ben5049/phy-module-hardware/README.md

# PHY Module Hardware

## 10BASE-T1S v1

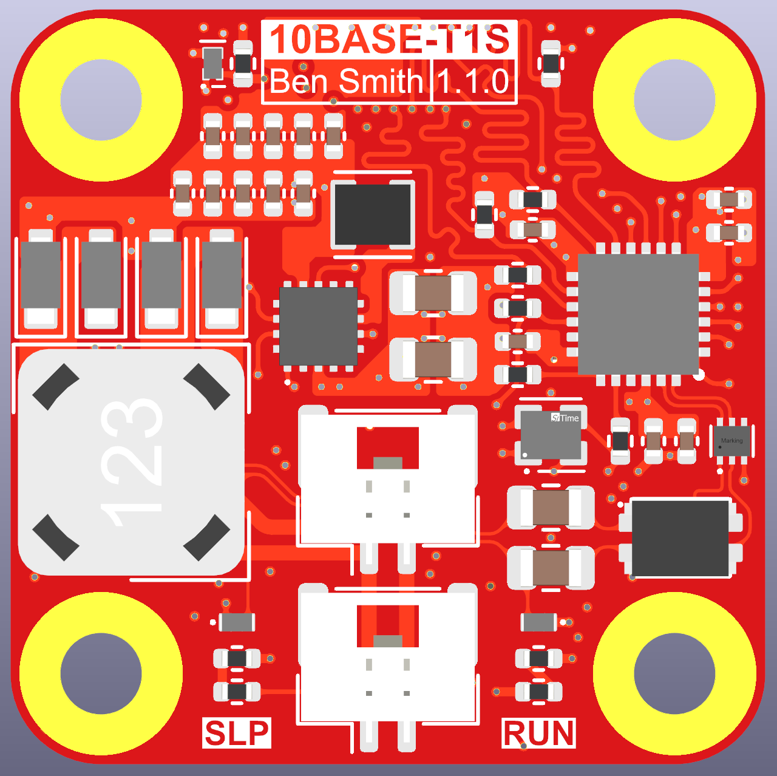
[picture p1: docs/images/10base-t1s.png]
10base-t1s


[Errata](/docs/errata.md#1-10base-t1s-phy-module-v1)

## 1000BASE-T1 v1

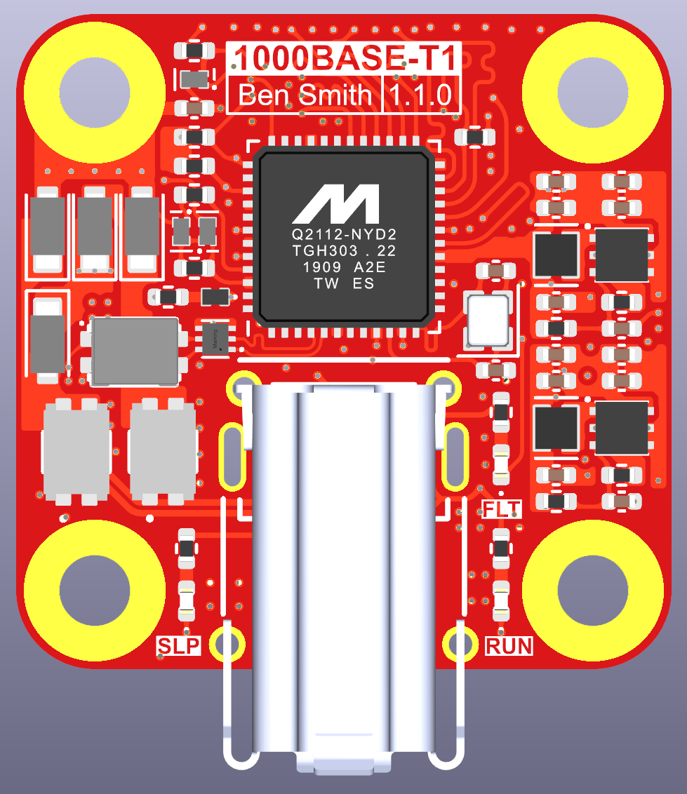
[picture p2: docs/images/1000base-t1.png]
1000base-t1


[Errata](/docs/errata.md#2-1000base-t1-phy-module-v1)
