ben5049/phy-module-hardware/docs/schematics/phy-module-10-base-t1s-v1.pdf

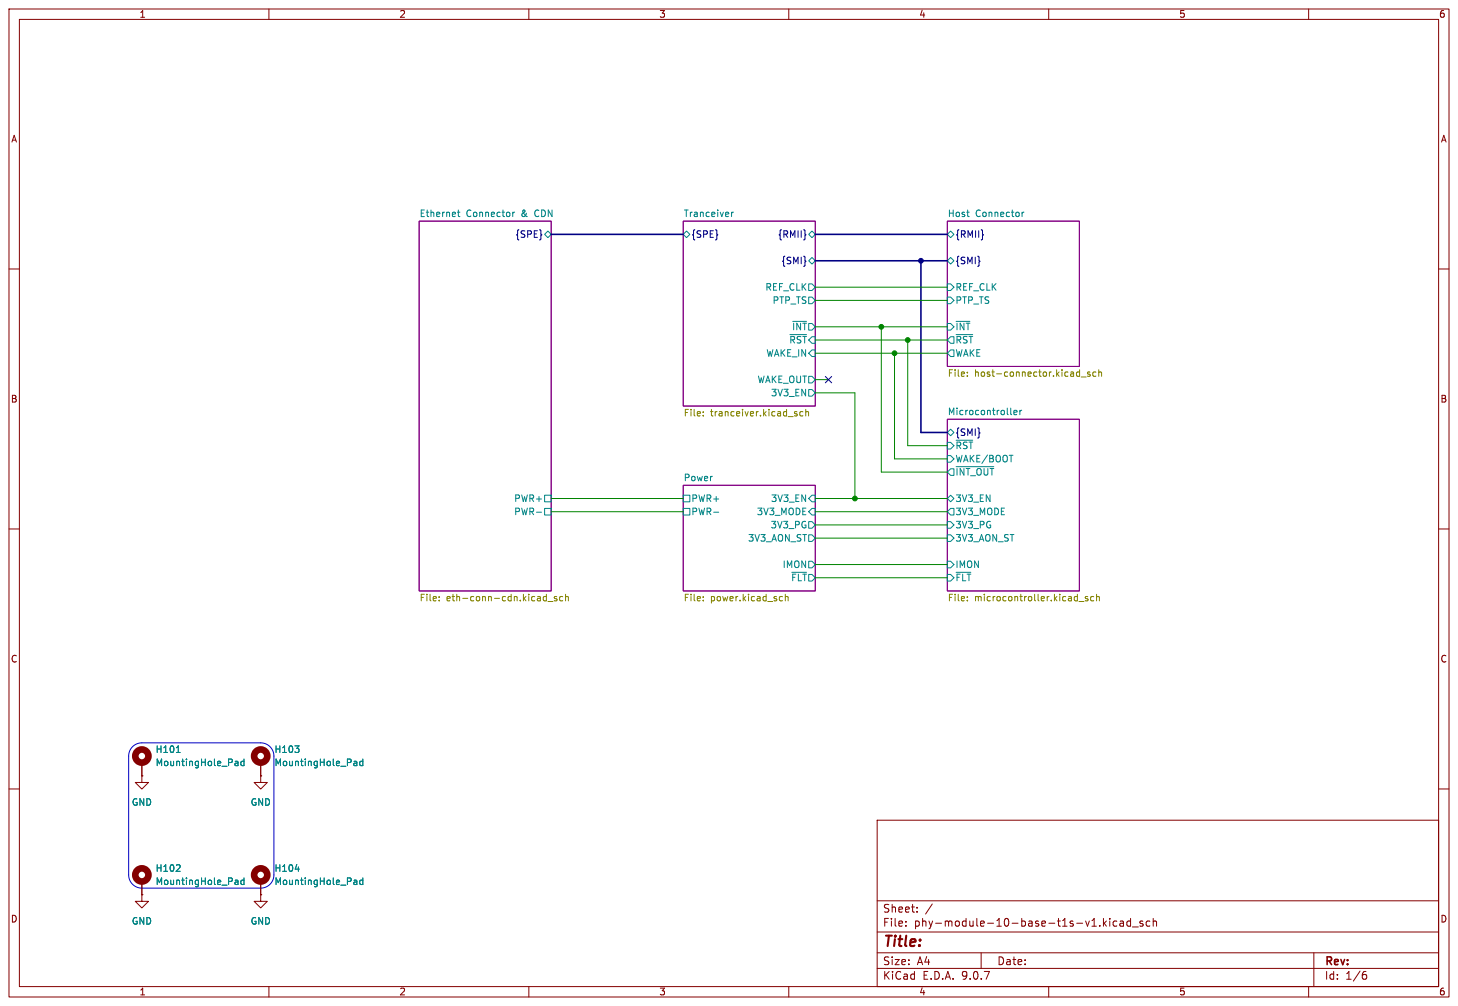
[picture p3: page 1]

~{RST} Host Connector File: host-connector.kicad_sch PWR+ PWR-

File: eth-conn-cdn.kicad_sch H101 MountingHole_Pad GND

Id: 1/6 Title: File: phy-module-10-base-t1s-v1.kicad_sch Sheet: /

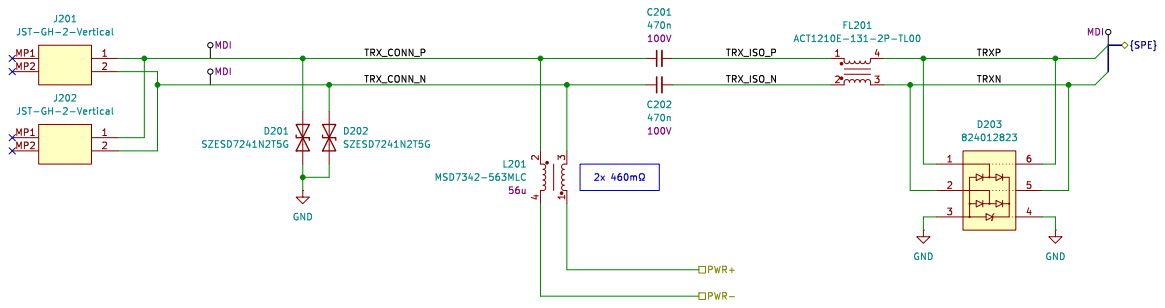
[picture p4: page 2]

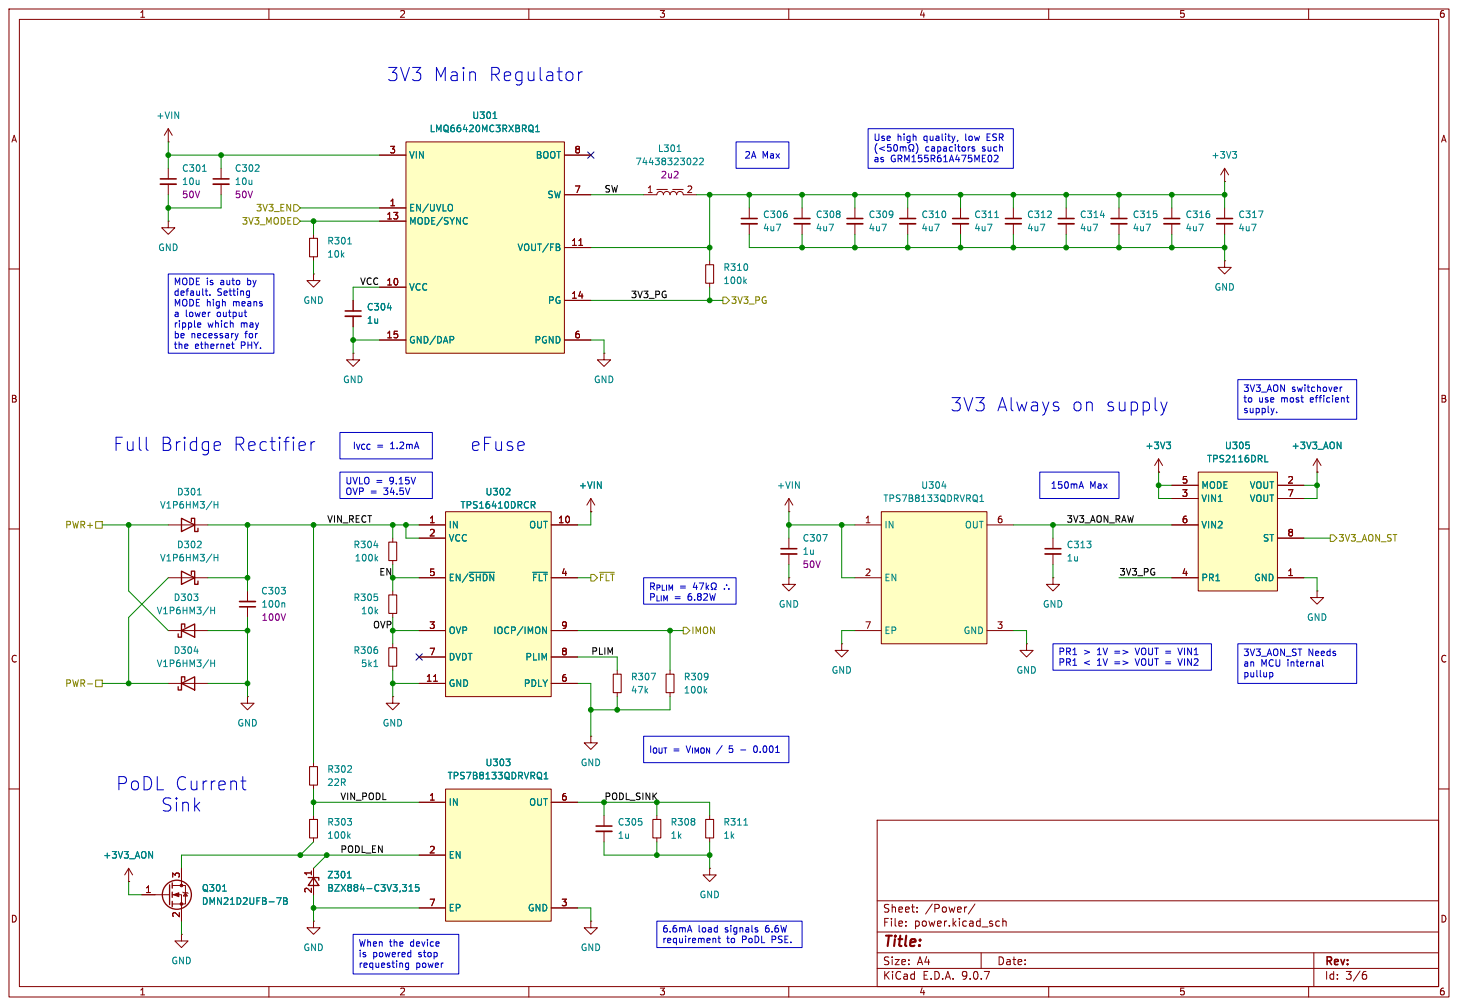
[picture p5: page 3]

as GRM155R61A475ME02 UVLO = 9.15V OVP = 34.5V When the device

to use most efficient supply.

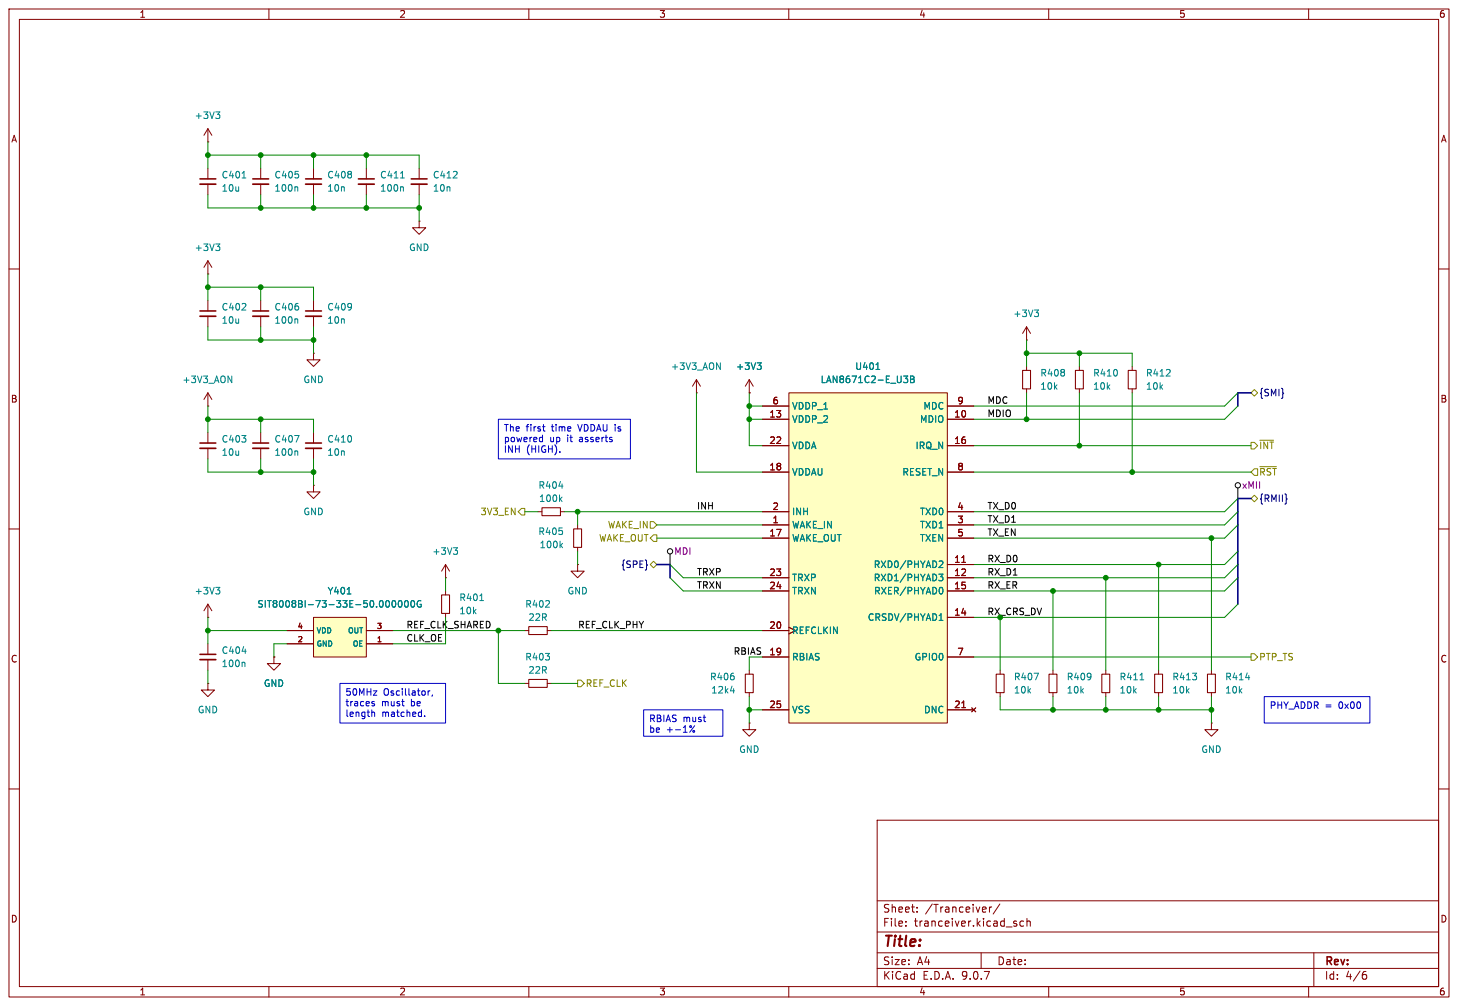
[picture p6: page 4]

The first time VDDAU is powered up it asserts

Id: 4/6 Title: File: tranceiver.kicad_sch Sheet: /Tranceiver/

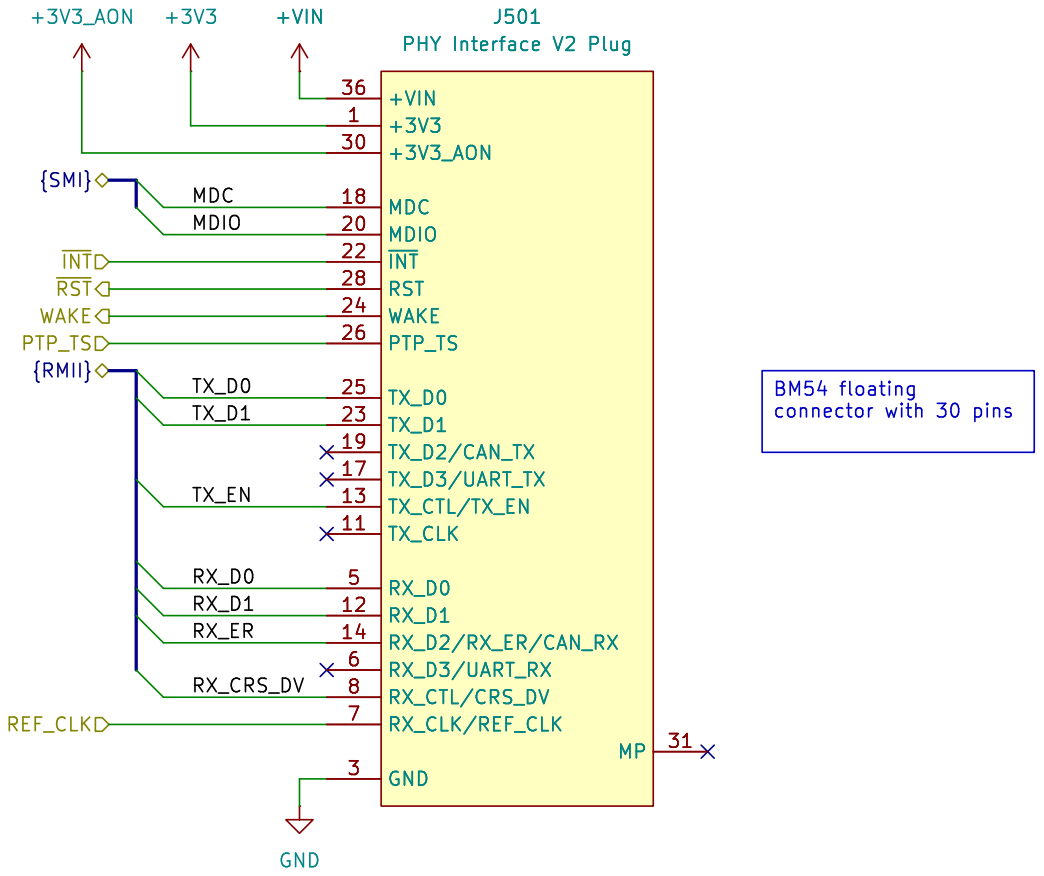
[picture p7: page 5]

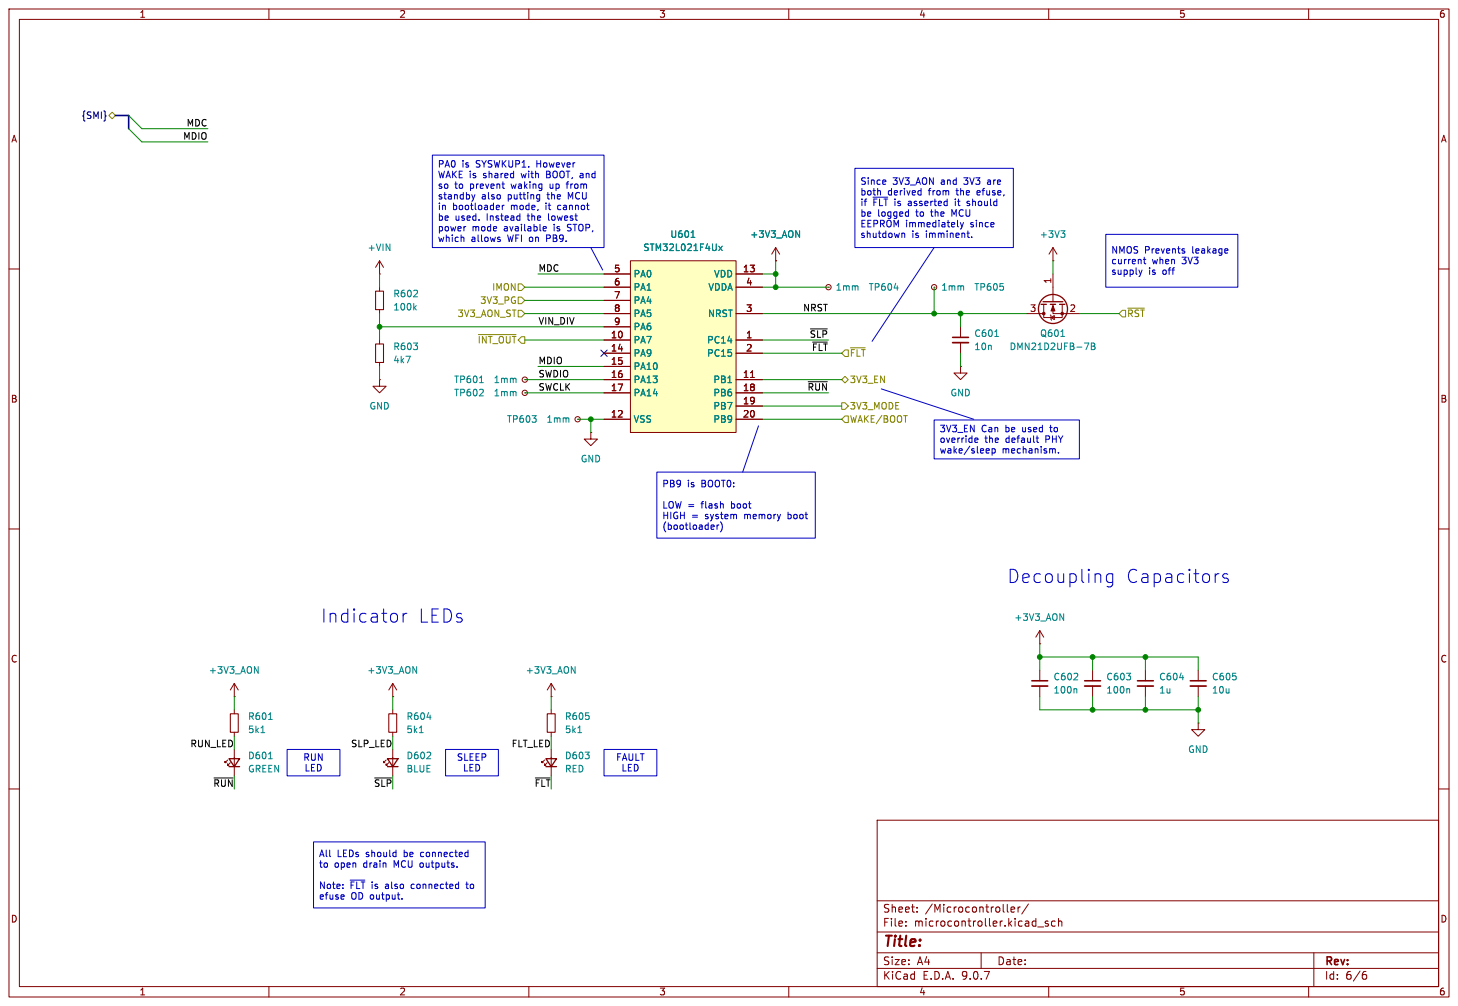
[picture p8: page 6]

PA0 is SYSWKUP1. However WAKE is shared with BOOT, and
so to prevent waking up from

both derived from the efuse,
if ~{FLT}is asserted it should
be logged to the MCU

shutdown is imminent. All LEDs should be connected

supply is off FAULT

3V3_EN Can be used to

Id: 6/6 Title: File: microcontroller.kicad_sch Sheet: /Microcontroller/
