ben5049/phy-module-hardware/docs/schematics/phy-module-1000-base-t1-v1.pdf

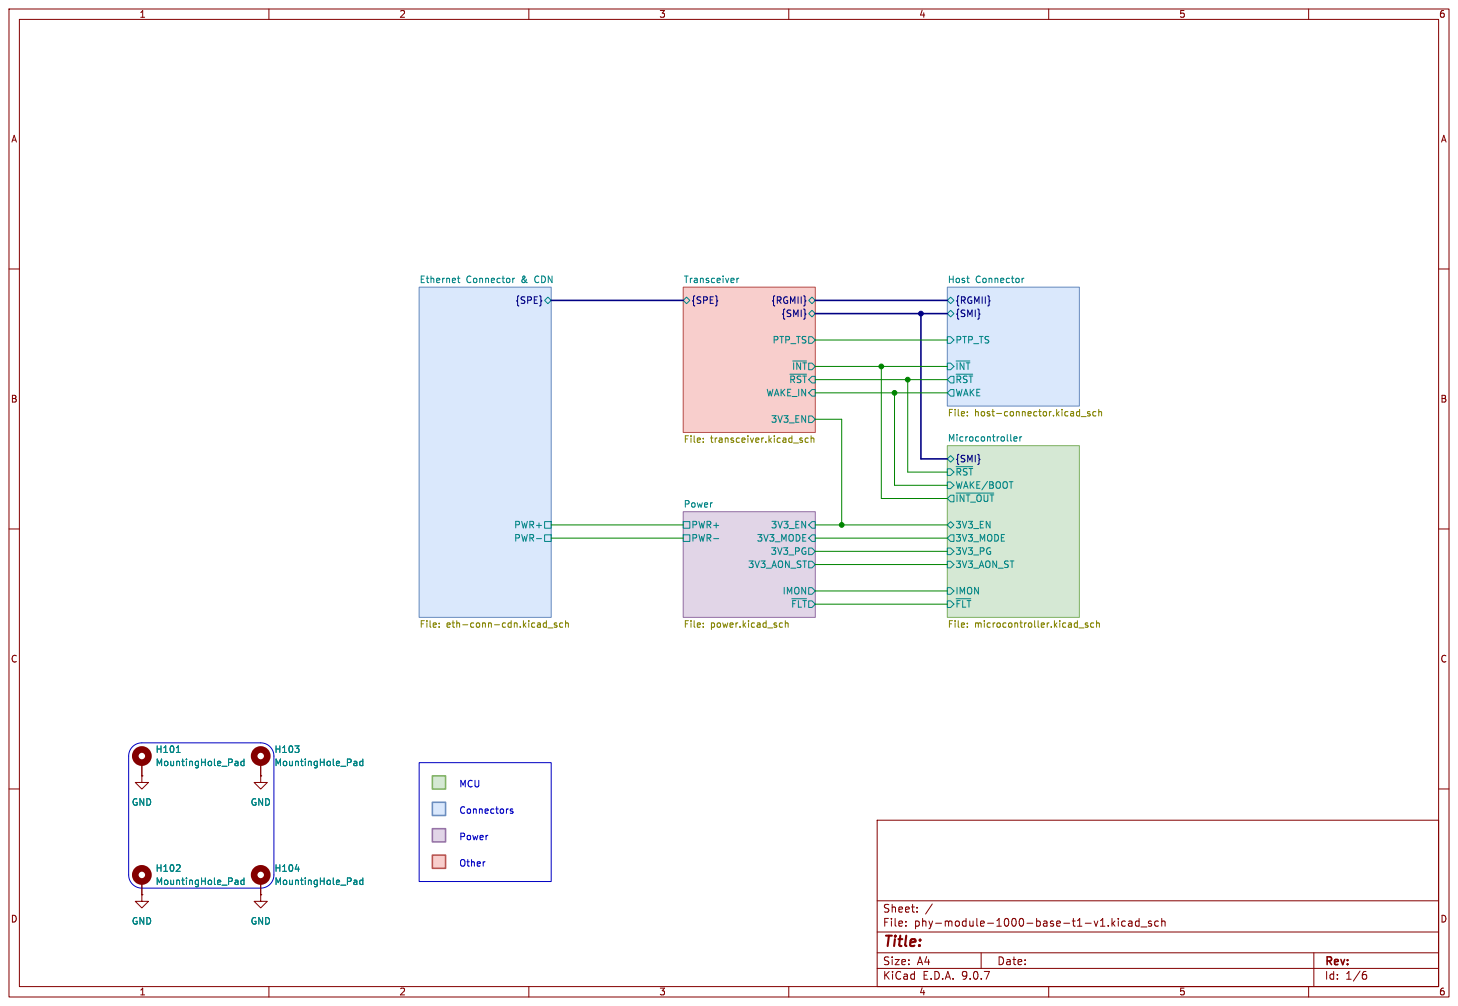
[picture p9: page 1]

{RGMII} Host Connector File: host-connector.kicad_sch
{SMI} PTP_TS WAKE

Id: 1/6 Title: File: phy-module-1000-base-t1-v1.kicad_sch Sheet: / WAKE_IN

{SMI} 3V3_MODE Microcontroller File: microcontroller.kicad_sch GND

Power File: power.kicad_sch PWR+ PWR-

File: eth-conn-cdn.kicad_sch

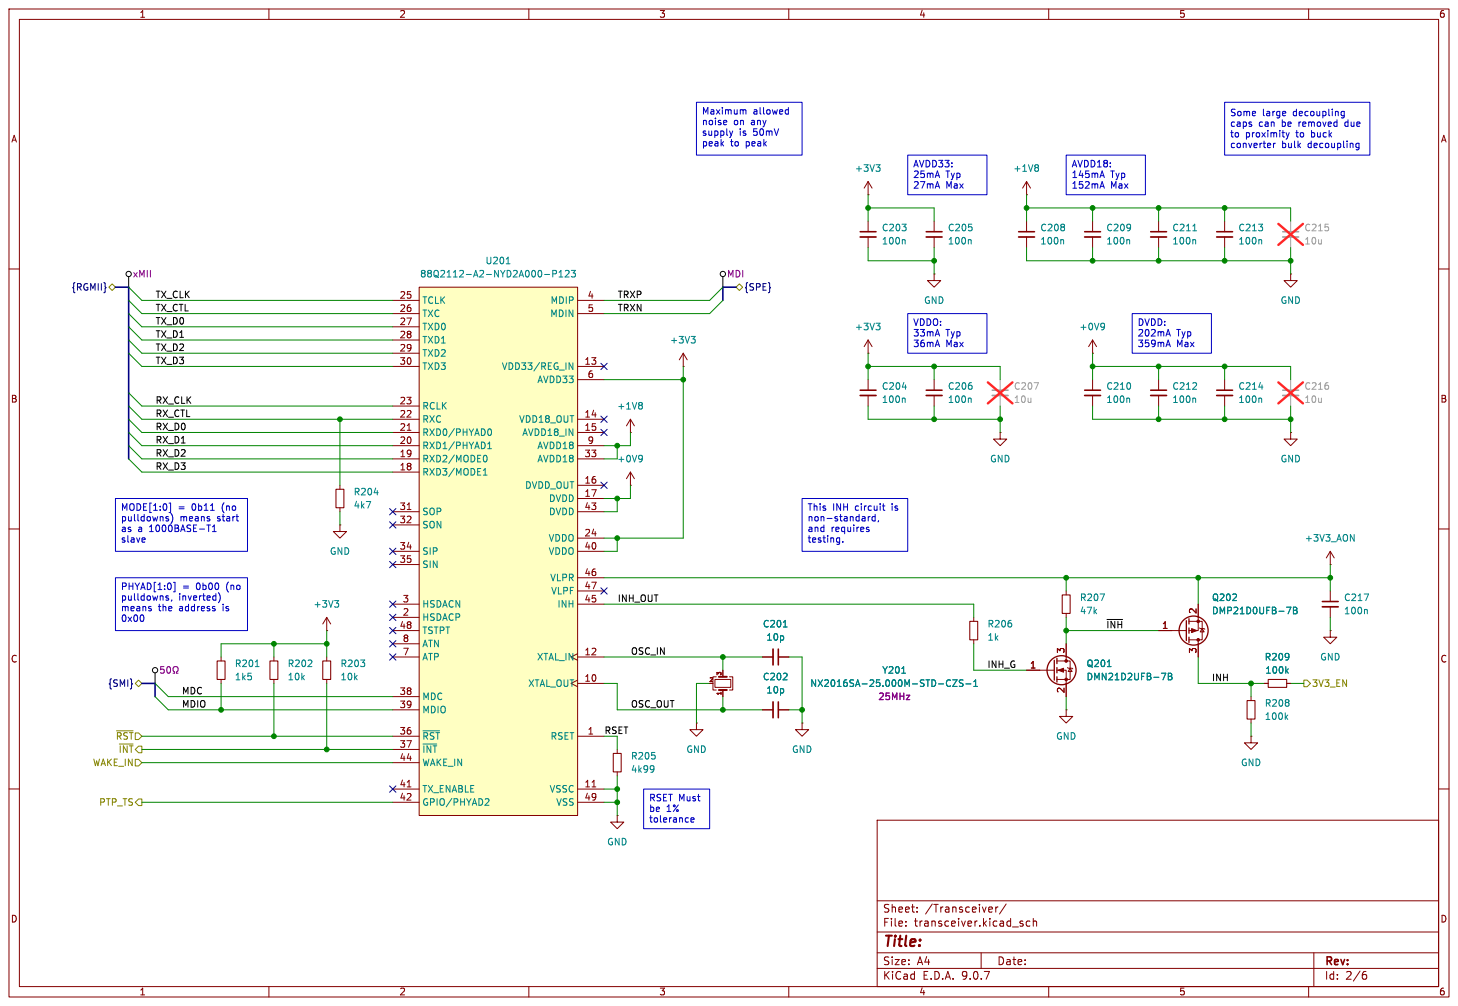
[picture p10: page 2]

caps can be removed due

359mA Max RSET Must be 1%

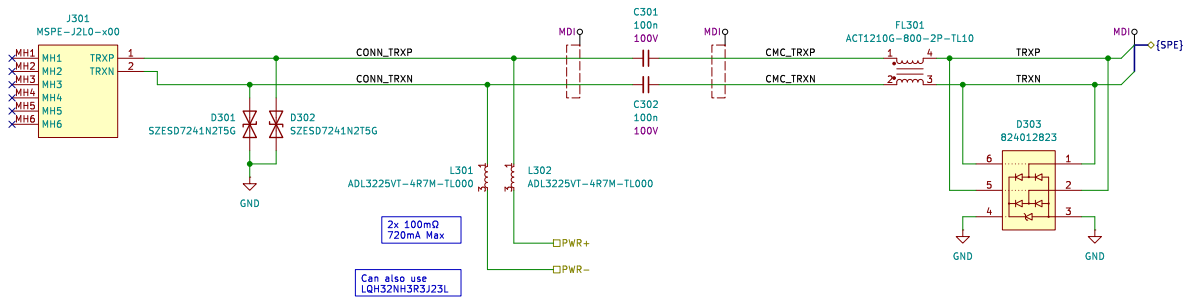
[picture p11: page 3]

720mA Max Can also use

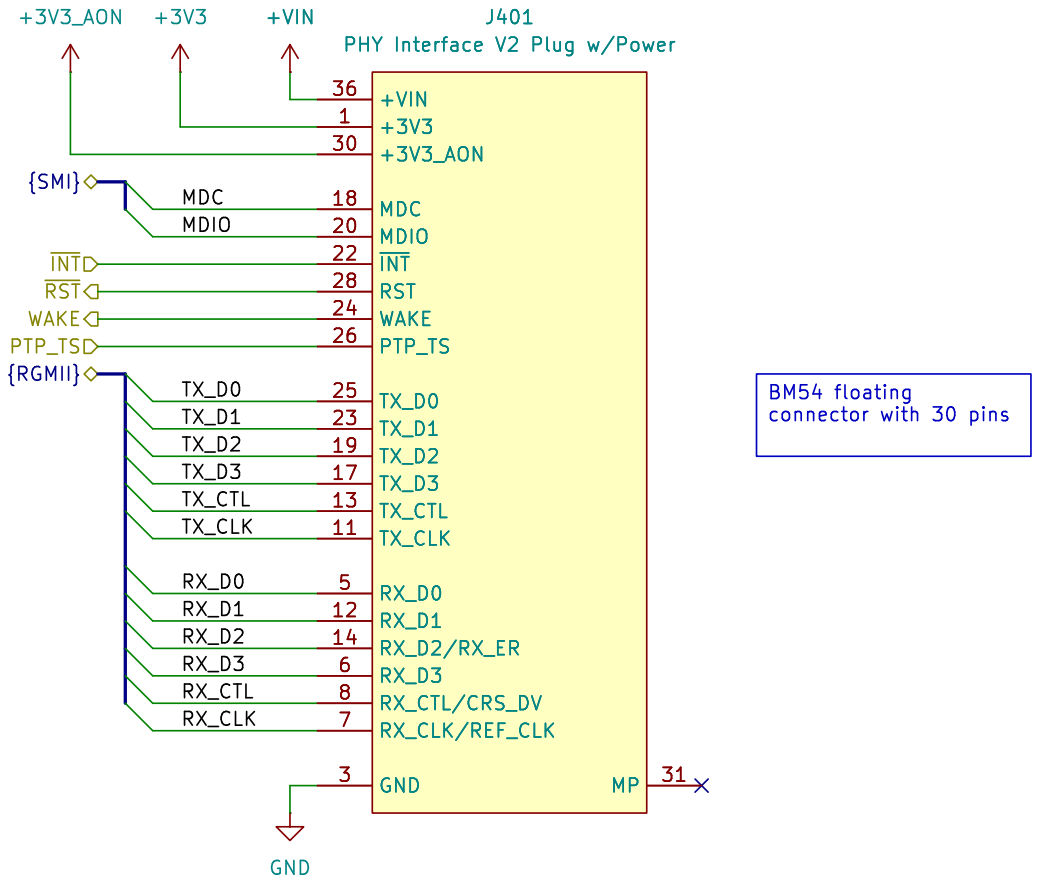
[picture p12: page 4]

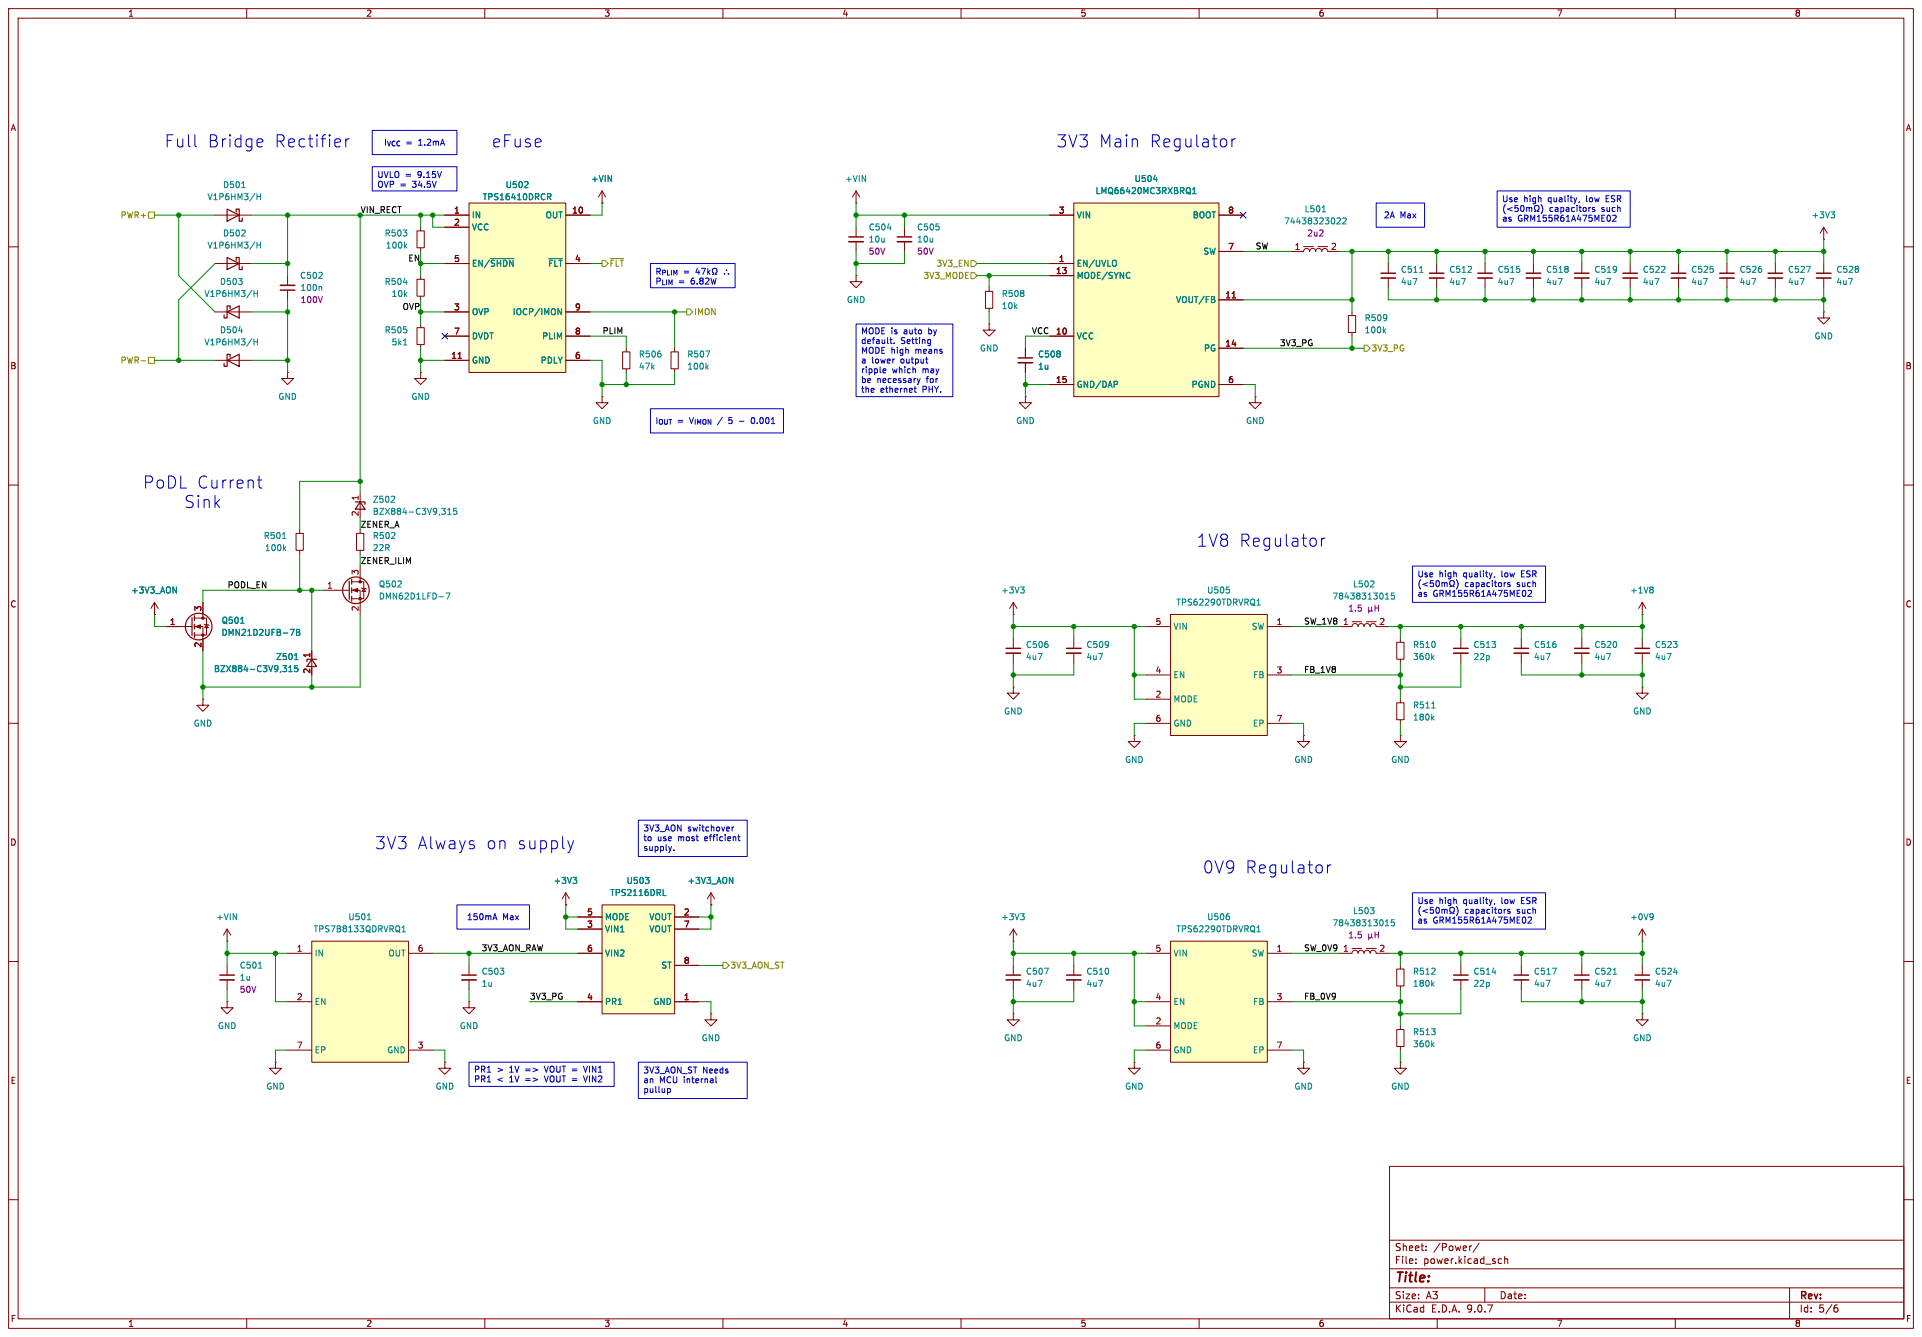
[picture p13: page 5]

as GRM155R61A475ME02 R_{PLIM} = þÿ47k©þÿ"4
P_{LIM}= 6.82W

I_{OUT} = V_{IMON} / 5 - 0.001 3V3 Always on supply

3V3_AON switchover
to use most efficient supply.

3V3_AON_ST Needs an MCU internal pullup

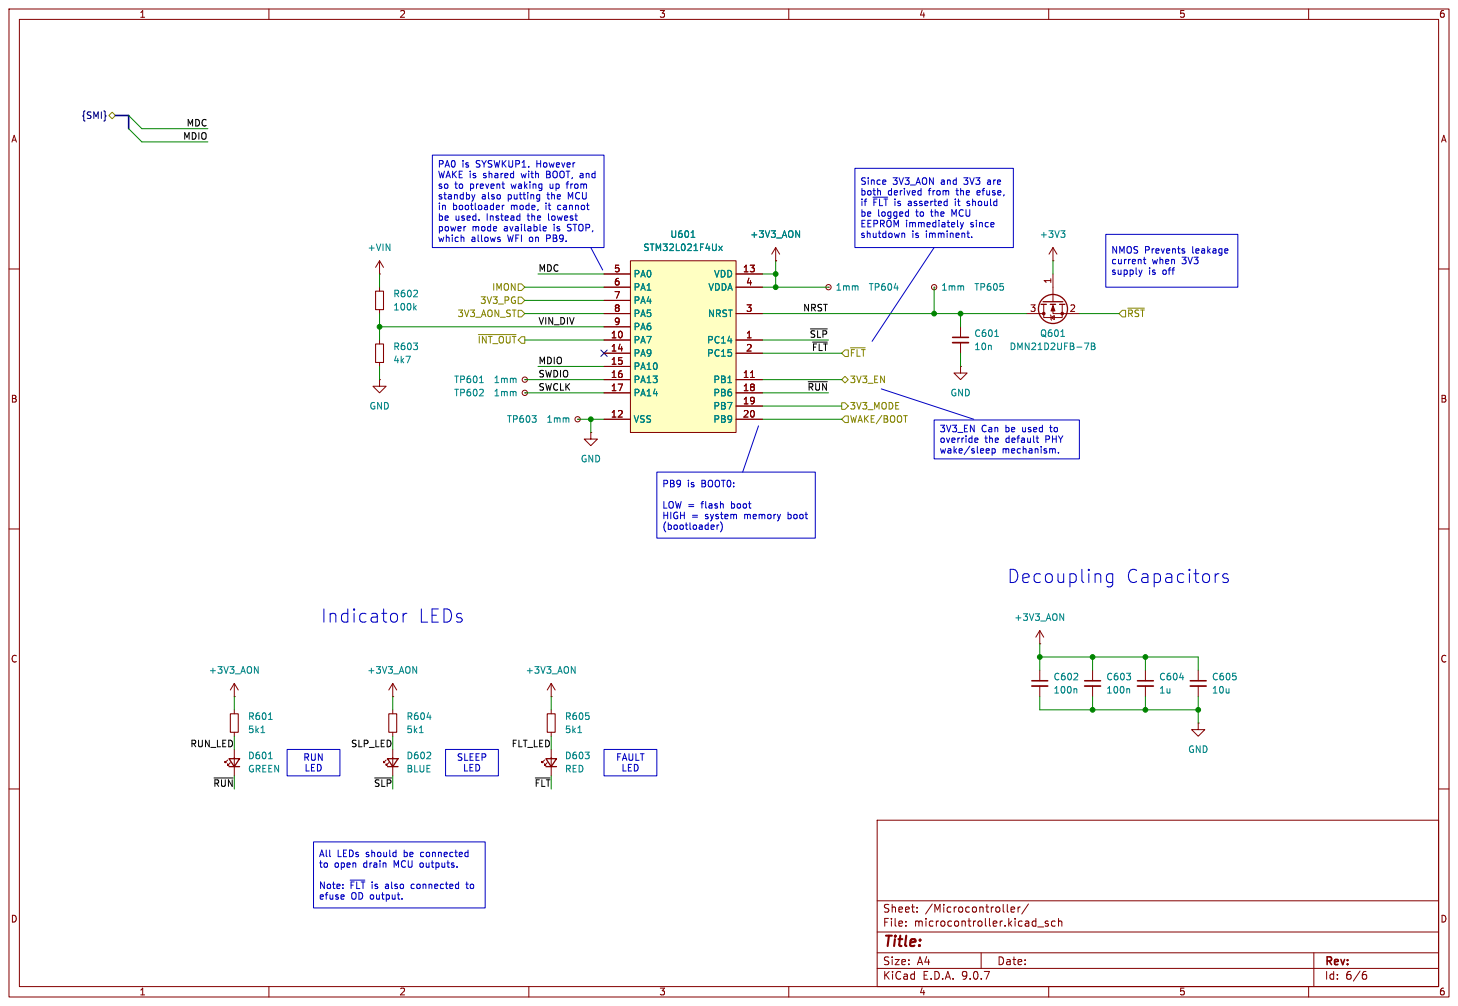
[picture p14: page 6]

PA0 is SYSWKUP1. However WAKE is shared with BOOT, and

so to prevent waking up from

supply is off Since 3V3_AON and 3V3 are
both derived from the efuse,
if ~{FLT}is asserted it should
be logged to the MCU

shutdown is imminent. PB9 is BOOT0: LOW = flash boot HIGH = system memory boot (bootloader) RUN

3V3_EN Can be used to

All LEDs should be connected

Id: 6/6 Title: File: microcontroller.kicad_sch Sheet: /Microcontroller/
