ben5049/phy-module-hardware/pcbs/term-10base-t1s-v1/term-10base-t1s-v1.kicad_pcb

## KiCad design pcbs/term-10base-t1s-v1/term-10base-t1s-v1.kicad_pcb (2026-05-05)

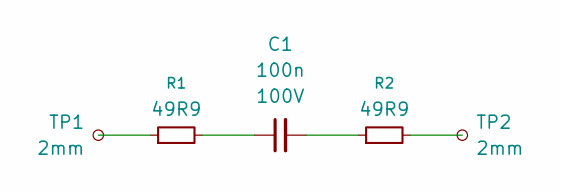
[picture p15: schematic term-10base-t1s-v1.kicad_sch]

Parts:
C1: 100n; C_0402_1005Metric; Voltage 100V
R1, R2: 49R9; R_0402_1005Metric
TP1, TP2: 2mm; TestPoint_Pad_D2.0mm

Connections:
unnamed: C1.1, R1.2
unnamed: C1.2, R2.1
unnamed: R1.1, TP1.1 (1_1)
unnamed: R2.2, TP2.1 (1_1)

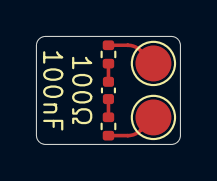
[picture p16: board term-10base-t1s-v1.kicad_pcb from above]

Board: 2 copper layers, 8.0 x 6.0 mm, 5 parts (0 on the bottom side), 4 nets.
