ben5049/phy-module-hardware/pcbs/phy-module-10-base-t1s-v1/phy-module-10-base-t1s-v1.kicad_pcb

## KiCad design pcbs/phy-module-10-base-t1s-v1/phy-module-10-base-t1s-v1.kicad_pcb (2026-05-05)

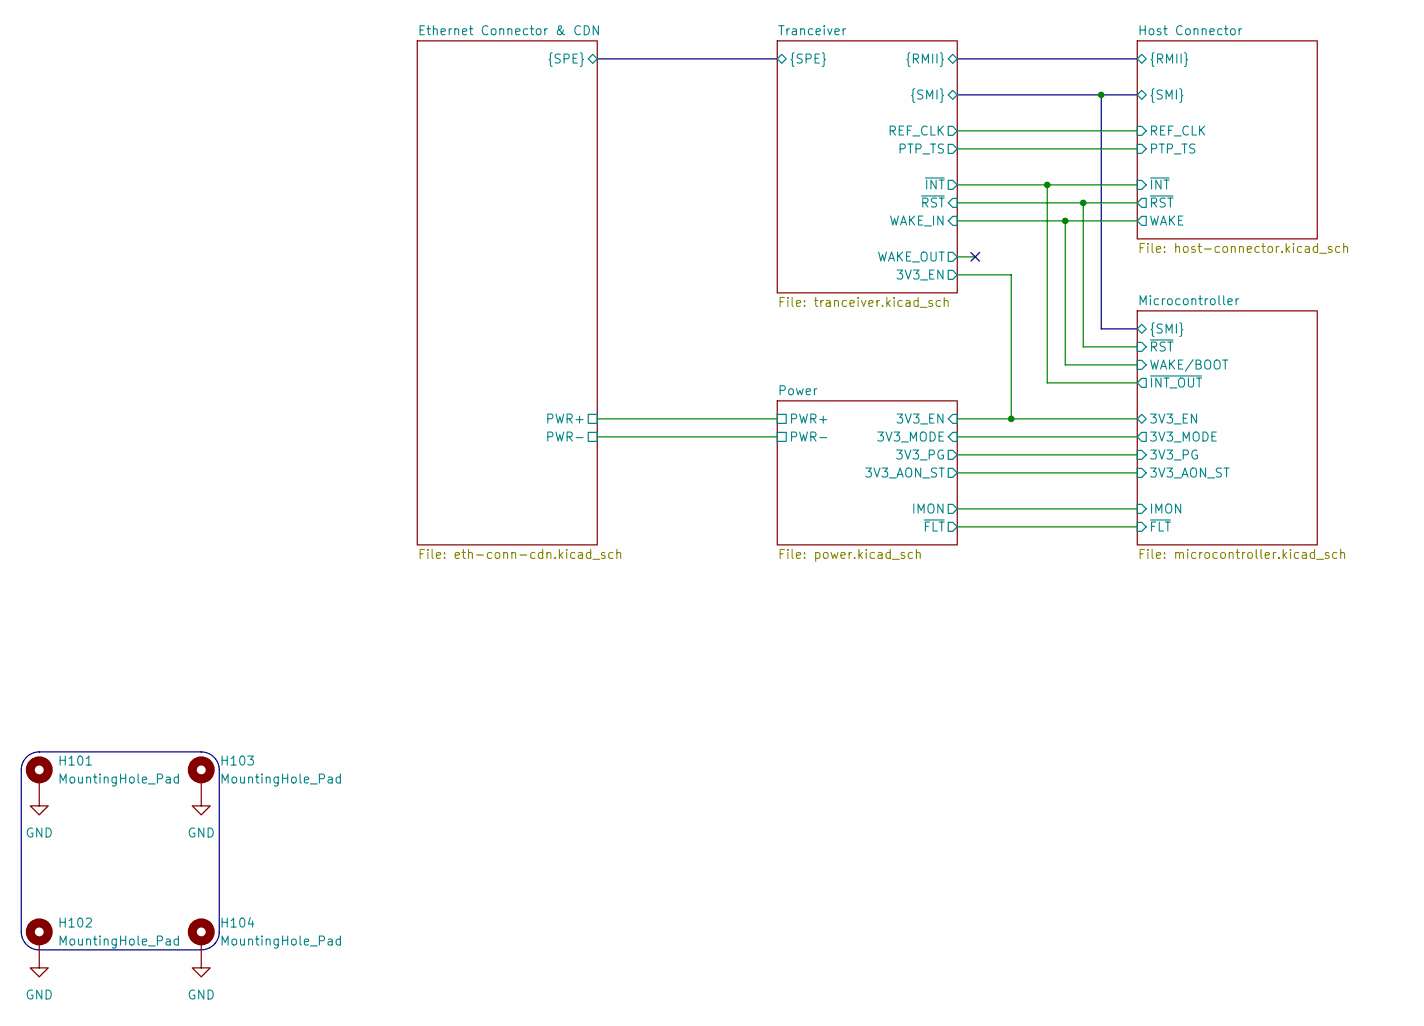
[picture p17: schematic phy-module-10-base-t1s-v1.kicad_sch]

Parts:
H101, H102, H103, H104: MountingHole_Pad; MountingHole_2.7mm_M2.5_Pad

Connections:
GND: H101.1 (1_1), H102.1 (1_1), H103.1 (1_1), H104.1 (1_1); also elsewhere on the board

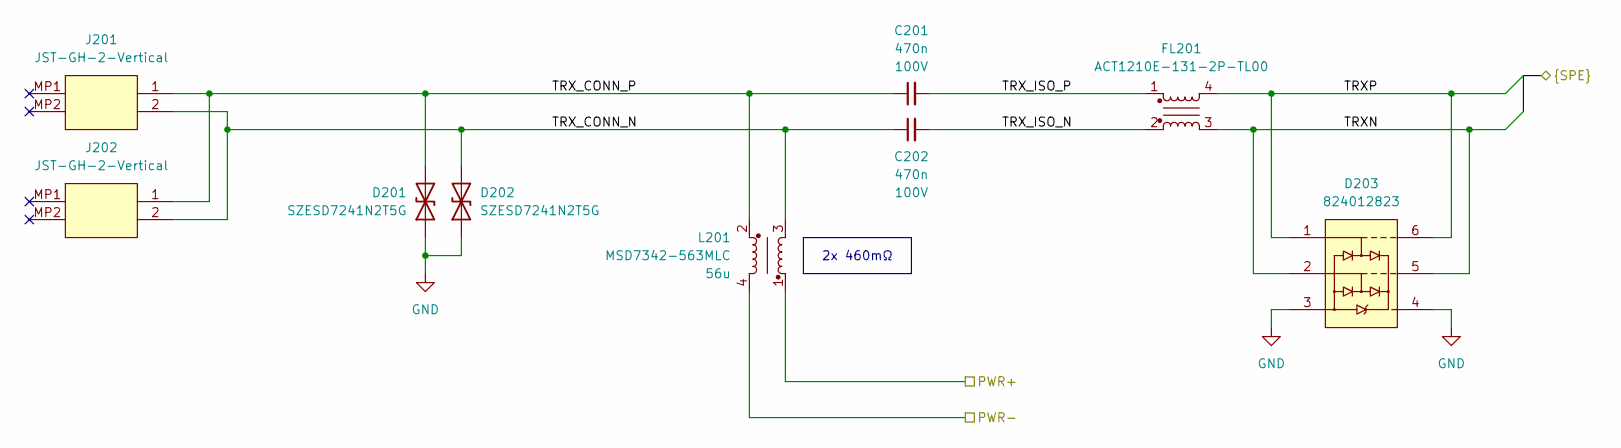
[picture p18: schematic eth-conn-cdn.kicad_sch]

Parts:
C201, C202: 470n; C_0805; Voltage 100V
D201, D202: SZESD7241N2T5G; SZESD7462N2T5G; Mouser Part Number 863-SZESD7241N2T5G
D203: 824012823; Mouser Part Number 710-824012823
FL201: ACT1210E-131-2P-TL00; ACT1210E; Mouser Part Number 810-ACT1210E1312PTL0
J201, J202: JST-GH-2-Vertical; JST_GH_BM02B-GHS-TBT_1x02-1MP_P1.25mm_Vertical
L201: MSD7342-563MLC; MSD7342

Connections:
/Ethernet Connector & CDN/PWR+: L201.1; also elsewhere on the board
/Ethernet Connector & CDN/PWR-: L201.4 (2); also elsewhere on the board
/Ethernet Connector & CDN/TRXN: D203.2, D203.5, FL201.3; also elsewhere on the board
/Ethernet Connector & CDN/TRXP: D203.1, D203.6, FL201.4; also elsewhere on the board
/Ethernet Connector & CDN/TRX_CONN_N: C202.1, D202.2 (A2), J201.2, J202.2, L201.3
/Ethernet Connector & CDN/TRX_CONN_P: C201.1, D201.2 (A2), J201.1, J202.1, L201.2 (4)
/Ethernet Connector & CDN/TRX_ISO_N: C202.2, FL201.2
/Ethernet Connector & CDN/TRX_ISO_P: C201.2, FL201.1
GND: D201.1 (A1), D202.1 (A1), D203.3, D203.4; also elsewhere on the board

Notes on the sheet:
2x 460mΩ

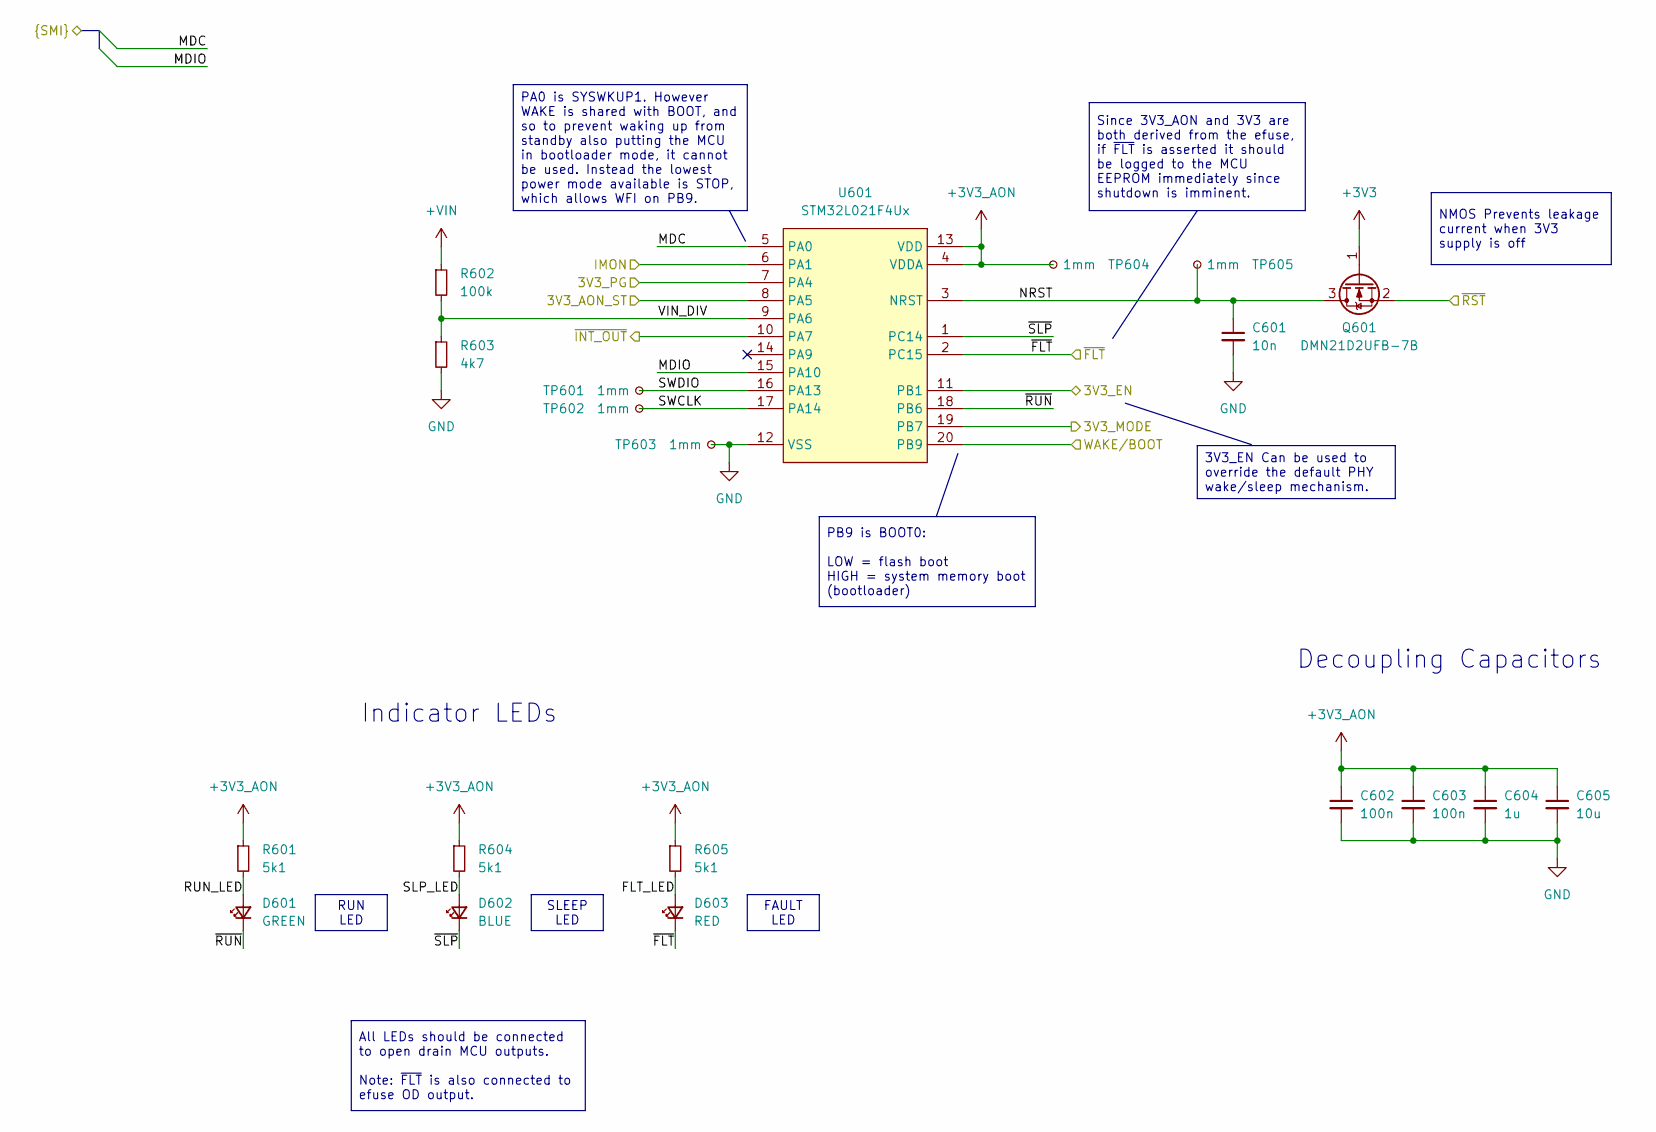
[picture p19: schematic microcontroller.kicad_sch]

Parts:
C601: 10n; C_0402
C602, C603: 100n; C_0402
C604: 1u; C_0402
C605: 10u; C_0402
D601: GREEN; LED_0402
D602: BLUE; LED_0402
D603: RED; LED_0402
Q601: DMN21D2UFB-7B; DMN21D2UFB7B; Mouser Part Number 621-DMN21D2UFB-7B
R601, R604, R605: 5k1; R_0402
R602: 100k; R_0402
R603: 4k7; R_0402
TP601, TP602, TP603, TP604, TP605: 1mm; TestPoint_Pad_D1.0mm
U601: STM32L021F4Ux; ST_UFQFPN-20_3x3mm_P0.5mm

Connections:
+3V3: Q601.1 (G); also elsewhere on the board
+3V3_AON: C602.1, C603.1, C604.1, C605.1, R601.1, R604.1, R605.1, TP604.1 (1_1), U601.4 (VDDA), U601.13 (VDD); also elsewhere on the board
+VIN: R602.1; also elsewhere on the board
/Host Connector/MDC: U601.5 (PA0); also elsewhere on the board
/Host Connector/MDIO: U601.15 (PA10); also elsewhere on the board
/Host Connector/WAKE: U601.20 (PB9); also elsewhere on the board
/Host Connector/~INT: U601.10 (PA7); also elsewhere on the board
/Host Connector/~RST: Q601.2 (S); also elsewhere on the board
/Microcontroller/3V3_AON_ST: U601.8 (PA5); also elsewhere on the board
/Microcontroller/3V3_EN: U601.11 (PB1); also elsewhere on the board
/Microcontroller/3V3_MODE: U601.19 (PB7); also elsewhere on the board
/Microcontroller/FLT_LED: D603.2 (A), R605.2
/Microcontroller/IMON: U601.6 (PA1); also elsewhere on the board
/Microcontroller/NRST: C601.1, Q601.3 (D), TP605.1 (1_1), U601.3 (NRST)
/Microcontroller/RUN_LED: D601.2 (A), R601.2
/Microcontroller/SLP_LED: D602.2 (A), R604.2
/Microcontroller/SWCLK: TP602.1 (1_1), U601.17 (PA14)
/Microcontroller/SWDIO: TP601.1 (1_1), U601.16 (PA13)
/Microcontroller/VIN_DIV: R602.2, R603.1, U601.9 (PA6)
/Microcontroller/~FLT: D603.1 (K), U601.2 (PC15); also elsewhere on the board
/Microcontroller/~RUN: D601.1 (K), U601.18 (PB6)
/Microcontroller/~SLP: D602.1 (K), U601.1 (PC14)
/Power/3V3_PG: U601.7 (PA4); also elsewhere on the board
GND: C601.2, C602.2, C603.2, C604.2, C605.2, R603.2, TP603.1 (1_1), U601.12 (VSS); also elsewhere on the board

Notes on the sheet:
Decoupling Capacitors
Indicator LEDs
RUN LED
PA0 is SYSWKUP1. However WAKE is shared with BOOT, and so to prevent waking up from standby also putting the MCU in bootloader mode, it cannot be used. Instead the lowest power mode available is STOP, which allows WFI on PB9.
PB9 is BOOT0: LOW = flash boot HIGH = system memory boot (bootloader)
FAULT LED
Since 3V3_AON and 3V3 are both derived from the efuse, if ~{FLT} is asserted it should be logged to the MCU EEPROM immediately since shutdown is imminent.
SLEEP LED
All LEDs should be connected to open drain MCU outputs. Note: ~{FLT} is also connected to efuse OD output.
3V3_EN Can be used to override the default PHY wake/sleep mechanism.
NMOS Prevents leakage current when 3V3 supply is off

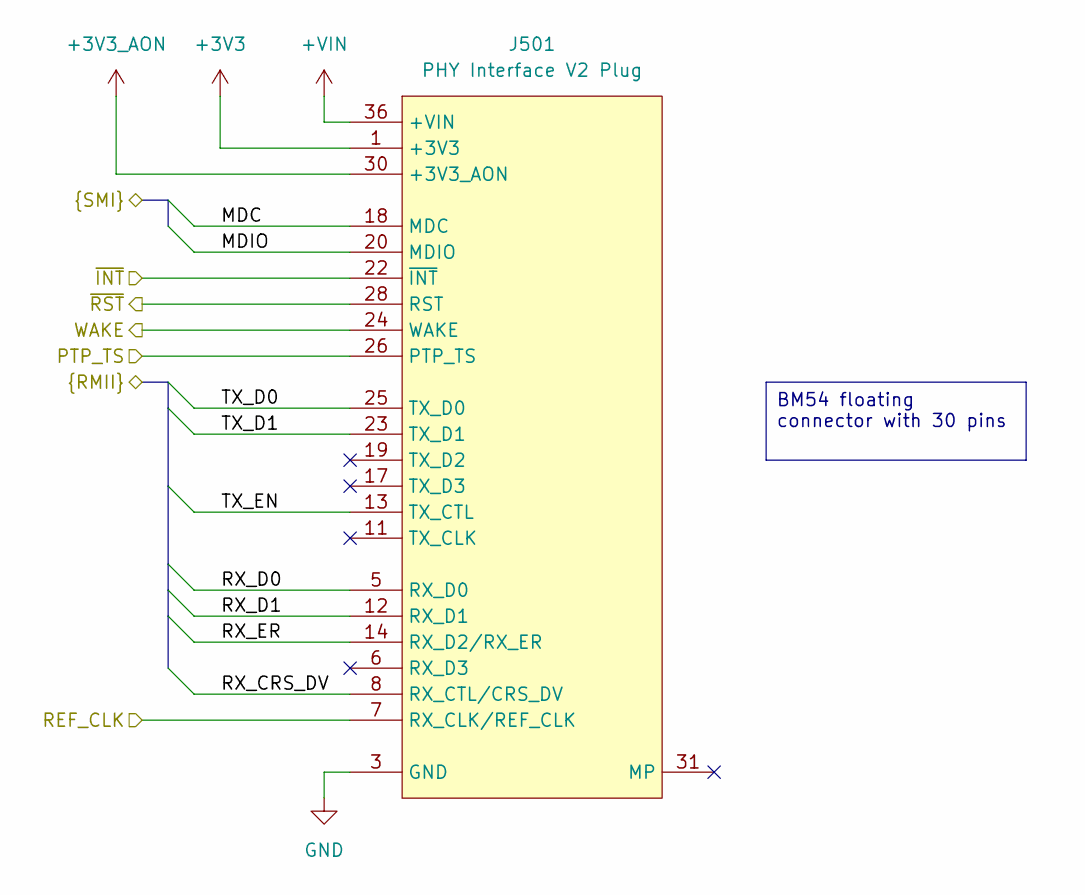
[picture p20: schematic host-connector.kicad_sch]

Parts:
J501: PHY Interface V2 Plug; BM54F3030DP04V51-PWR

Connections:
+3V3: J501.1 (+3V3), J501.2 (+3V3), J501.29 (+3V3); also elsewhere on the board
+3V3_AON: J501.30 (+3V3_AON); also elsewhere on the board
+VIN: J501.36 (+VIN); also elsewhere on the board
/Host Connector/MDC: J501.18 (MDC); also elsewhere on the board
/Host Connector/MDIO: J501.20 (MDIO); also elsewhere on the board
/Host Connector/PTP_TS: J501.26 (PTP_TS); also elsewhere on the board
/Host Connector/REF_CLK: J501.7 (RX_CLK/REF_CLK); also elsewhere on the board
/Host Connector/RX_CRS_DV: J501.8 (RX_CTL/CRS_DV); also elsewhere on the board
/Host Connector/RX_D0: J501.5 (RX_D0); also elsewhere on the board
/Host Connector/RX_D1: J501.12 (RX_D1); also elsewhere on the board
/Host Connector/RX_ER: J501.14 (RX_D2/RX_ER); also elsewhere on the board
/Host Connector/TX_D0: J501.25 (TX_D0); also elsewhere on the board
/Host Connector/TX_D1: J501.23 (TX_D1); also elsewhere on the board
/Host Connector/TX_EN: J501.13 (TX_CTL); also elsewhere on the board
/Host Connector/WAKE: J501.24 (WAKE); also elsewhere on the board
/Host Connector/~INT: J501.22 (~INT); also elsewhere on the board
/Host Connector/~RST: J501.28 (RST); also elsewhere on the board
GND: J501.3 (GND), J501.4 (GND), J501.9 (GND), J501.10 (GND), J501.15 (GND), J501.16 (GND), J501.21 (GND), J501.27 (GND), J501.35 (GND); also elsewhere on the board

Notes on the sheet:
BM54 floating connector with 30 pins

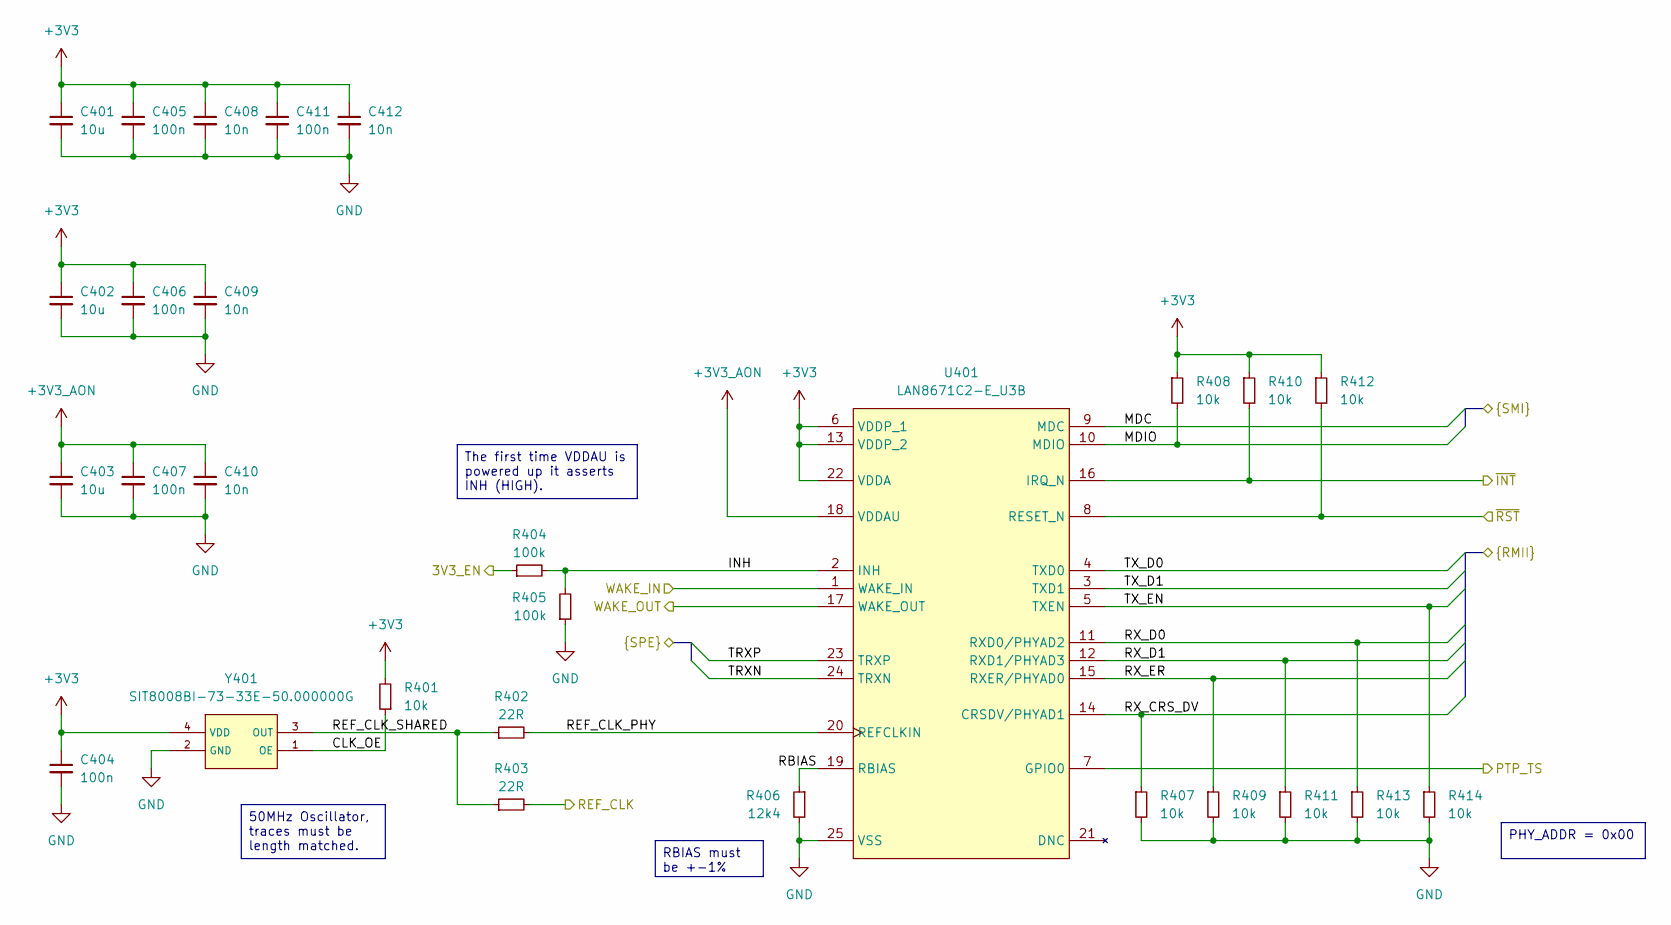
[picture p21: schematic tranceiver.kicad_sch]

Parts:
C401, C402, C403: 10u; C_0402
C404, C405, C406, C407, C411: 100n; C_0402
C408, C409, C410, C412: 10n; C_0402
R401, R407, R408, R409, R410, R411, R412, R413, R414: 10k; R_0402
R402, R403: 22R; R_0402
R404, R405: 100k; R_0402
R406: 12k4; R_0402
U401: LAN8671C2-E_U3B; QFN50P400X400X100-25N-D; Mouser Part Number 579-LAN8671C2-E/U3B
Y401: SIT8008BI-73-33E-50.000000G; SiTime-SiT8008-7-0-0-MFG; mouser part number 788-8008BI7333E500G; digikey description MEMS OSC XO 50.0000MHZ H/LV-CMOS

Connections:
+3V3: C401.1, C402.1, C404.1, C405.1, C406.1, C408.1, C409.1, C411.1, C412.1, R401.2, R408.1, R410.1, R412.1, U401.6 (VDDP_1), U401.13 (VDDP_2), U401.22 (VDDA), Y401.4 (VDD); also elsewhere on the board
+3V3_AON: C403.1, C407.1, C410.1, U401.18 (VDDAU); also elsewhere on the board
/Ethernet Connector & CDN/TRXN: U401.24 (TRXN); also elsewhere on the board
/Ethernet Connector & CDN/TRXP: U401.23 (TRXP); also elsewhere on the board
/Host Connector/MDC: U401.9 (MDC); also elsewhere on the board
/Host Connector/MDIO: R408.2, U401.10 (MDIO); also elsewhere on the board
/Host Connector/PTP_TS: U401.7 (GPIO0); also elsewhere on the board
/Host Connector/REF_CLK: R403.2; also elsewhere on the board
/Host Connector/RX_CRS_DV: R407.1, U401.14 (CRSDV/PHYAD1); also elsewhere on the board
/Host Connector/RX_D0: R413.1, U401.11 (RXD0/PHYAD2); also elsewhere on the board
/Host Connector/RX_D1: R411.1, U401.12 (RXD1/PHYAD3); also elsewhere on the board
/Host Connector/RX_ER: R409.1, U401.15 (RXER/PHYAD0); also elsewhere on the board
/Host Connector/TX_D0: U401.4 (TXD0); also elsewhere on the board
/Host Connector/TX_D1: U401.3 (TXD1); also elsewhere on the board
/Host Connector/TX_EN: R414.1, U401.5 (TXEN); also elsewhere on the board
/Host Connector/WAKE: U401.1 (WAKE_IN); also elsewhere on the board
/Host Connector/~INT: R410.2, U401.16 (IRQ_N); also elsewhere on the board
/Host Connector/~RST: R412.2, U401.8 (RESET_N); also elsewhere on the board
/Microcontroller/3V3_EN: R404.1; also elsewhere on the board
/Tranceiver/CLK_OE: R401.1, Y401.1 (OE)
/Tranceiver/INH: R404.2, R405.2, U401.2 (INH)
/Tranceiver/RBIAS: R406.1, U401.19 (RBIAS)
/Tranceiver/REF_CLK_PHY: R402.2, U401.20 (REFCLKIN)
/Tranceiver/REF_CLK_SHARED: R402.1, R403.1, Y401.3 (OUT)
/Tranceiver/WAKE_OUT: U401.17 (WAKE_OUT)
GND: C401.2, C402.2, C403.2, C404.2, C405.2, C406.2, C407.2, C408.2, C409.2, C410.2, C411.2, C412.2, R405.1, R406.2, R407.2, R409.2, R411.2, R413.2, R414.2, U401.25 (VSS), Y401.2 (GND); also elsewhere on the board

Notes on the sheet:
50MHz Oscillator, traces must be length matched.
PHY_ADDR = 0x00
RBIAS must be +-1%
The first time VDDAU is powered up it asserts INH (HIGH).

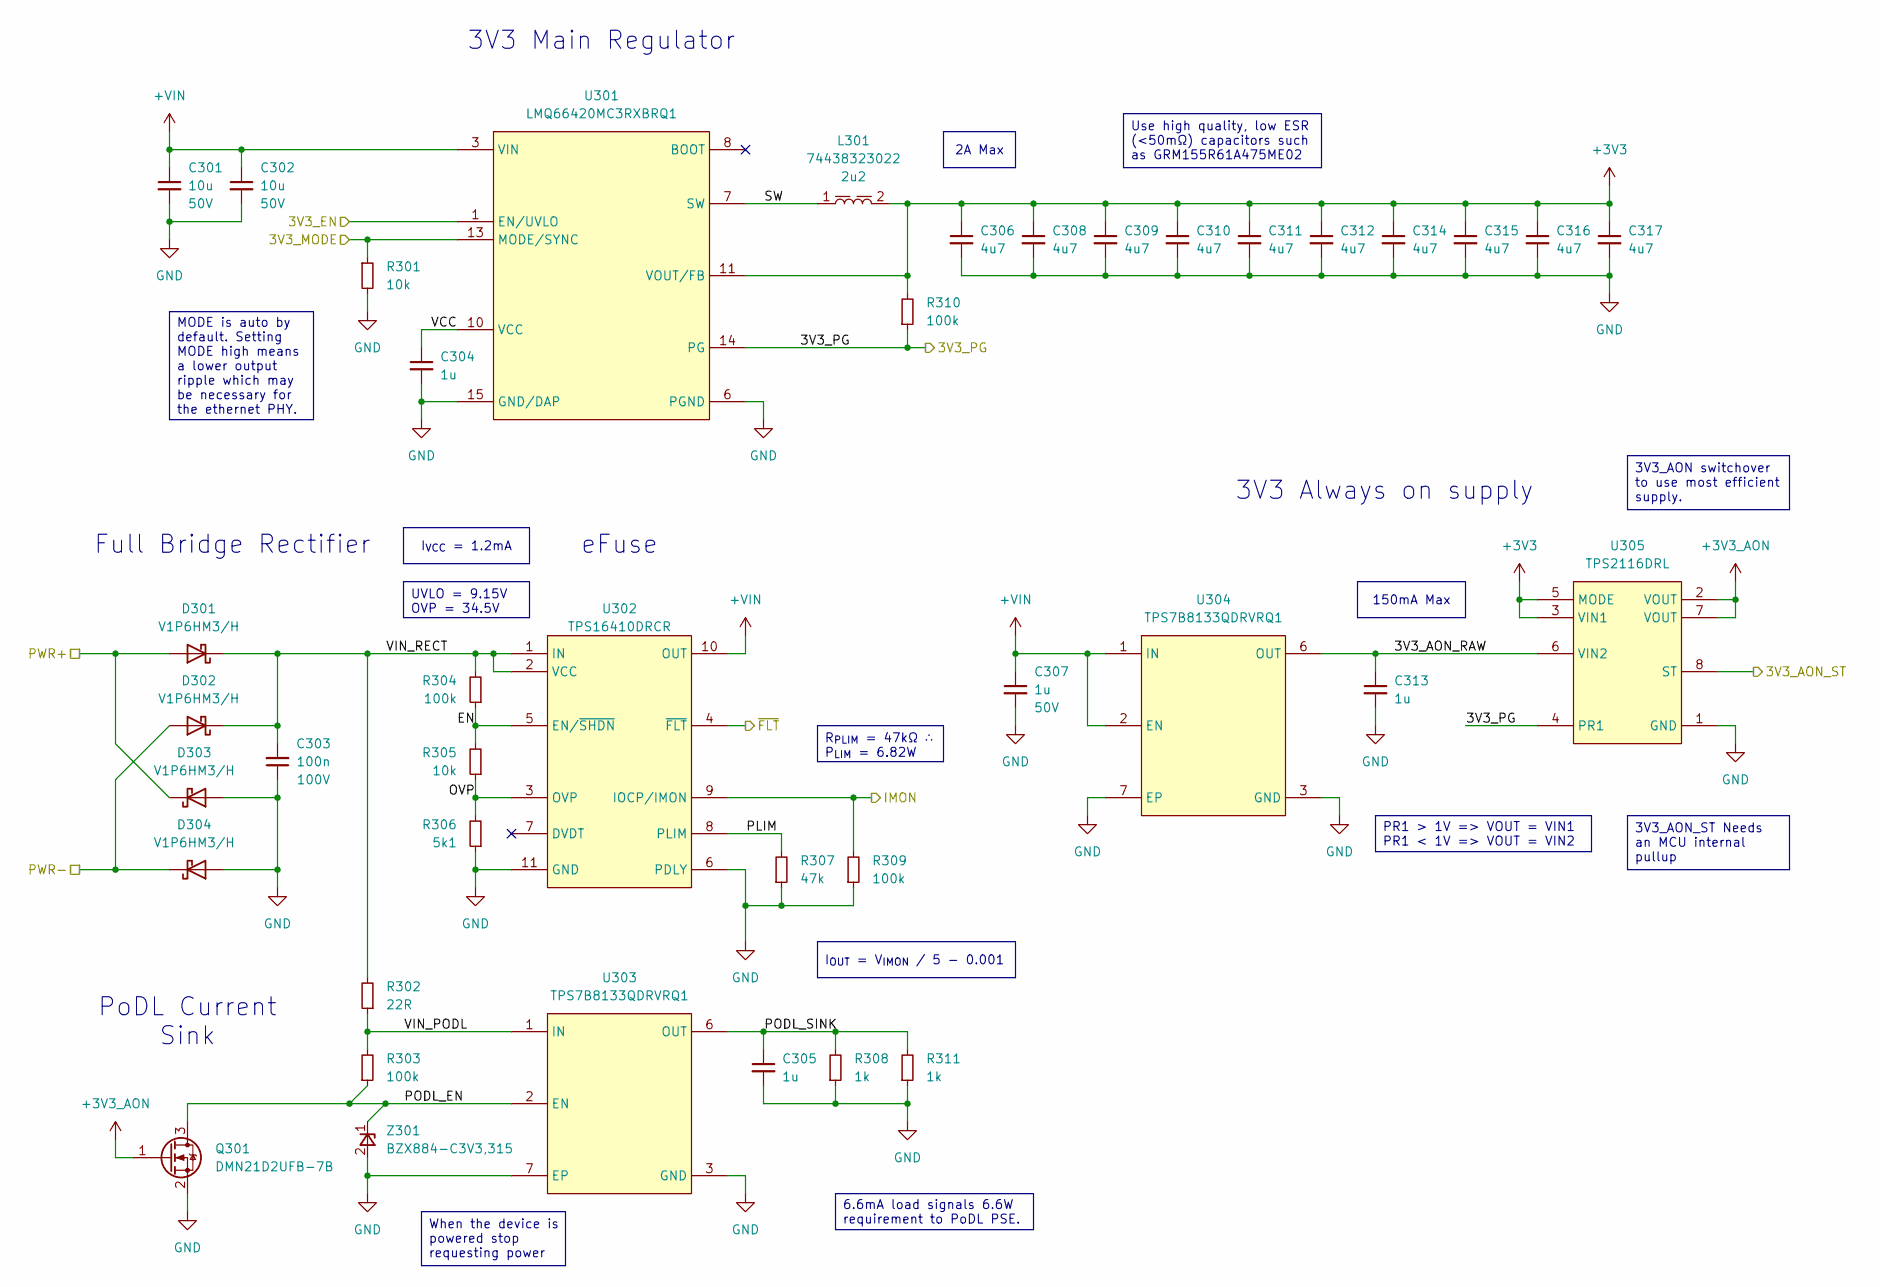
[picture p22: schematic power.kicad_sch]

Parts:
C301, C302: 10u; C_0805; Voltage 50V
C303: 100n; C_0402; Voltage 100V
C304, C305, C313: 1u; C_0402
C306, C308, C309, C310, C311, C312, C314, C315, C316, C317: 4u7; C_0402
C307: 1u; C_0402; Voltage 50V
D301, D302, D303, D304: V1P6HM3/H; V1P6HM3_H
L301: 74438323022; L_Wurth_WE-MAPI-2510; Part Number 74438323022
Q301: DMN21D2UFB-7B; DMN21D2UFB7B; Mouser Part Number 621-DMN21D2UFB-7B
R301, R305: 10k; R_0402
R302: 22R; R_0402
R303, R304, R309, R310: 100k; R_0402
R306: 5k1; R_0402
R307: 47k; R_0402
R308, R311: 1k; R_0402
U301: LMQ66420MC3RXBRQ1; LMQ664x0
U302: TPS16410DRCR; Mouser Part Number 595-TPS16410DRCR
U303, U304: TPS7B8133QDRVRQ1; SON65P200X200X80-7N; Mouser Part Number 595-TPS7B8133QDRVRQ1
U305: TPS2116DRL; SOTFL50P160X60-8N
Z301: BZX884-C3V3,315; BZX884; Mouser Part Number 771-BZX884-C3V9315

Connections:
+3V3: C306.1, C308.1, C309.1, C310.1, C311.1, C312.1, C314.1, C315.1, C316.1, C317.1, L301.2, R310.2, U301.11 (VOUT/FB), U305.3 (VIN1), U305.5 (MODE); also elsewhere on the board
+3V3_AON: Q301.1 (G), U305.2 (VOUT), U305.7 (VOUT); also elsewhere on the board
+VIN: C301.1, C302.1, C307.1, U301.3 (VIN), U302.10 (OUT), U304.1 (IN), U304.2 (EN); also elsewhere on the board
/Ethernet Connector & CDN/PWR+: D301.2 (A), D303.1 (K); also elsewhere on the board
/Ethernet Connector & CDN/PWR-: D302.2 (A), D304.1 (K); also elsewhere on the board
/Microcontroller/3V3_AON_ST: U305.8 (ST); also elsewhere on the board
/Microcontroller/3V3_EN: U301.1 (EN/UVLO); also elsewhere on the board
/Microcontroller/3V3_MODE: R301.1, U301.13 (MODE/SYNC); also elsewhere on the board
/Microcontroller/IMON: R309.2, U302.9 (IOCP/IMON); also elsewhere on the board
/Microcontroller/~FLT: U302.4 (~FLT); also elsewhere on the board
/Power/3V3_AON_RAW: C313.1, U304.6 (OUT), U305.6 (VIN2)
/Power/3V3_PG: R310.1, U301.14 (PG), U305.4 (PR1); also elsewhere on the board
/Power/EN: R304.1, R305.2, U302.5 (EN/~SHDN)
/Power/OVP: R305.1, R306.2, U302.3 (OVP)
/Power/PLIM: R307.2, U302.8 (PLIM)
/Power/PODL_EN: Q301.3 (D), R303.1, U303.2 (EN), Z301.1 (K)
/Power/PODL_SINK: C305.1, R308.2, R311.2, U303.6 (OUT)
/Power/SW: L301.1, U301.7 (SW)
/Power/VCC: C304.1, U301.10 (VCC)
/Power/VIN_PODL: R302.1, R303.2, U303.1 (IN)
/Power/VIN_RECT: C303.2, D301.1 (K), D302.1 (K), R302.2, R304.2, U302.1 (IN), U302.2 (VCC)
GND: C301.2, C302.2, C303.1, C304.2, C305.2, C306.2, C307.2, C308.2, C309.2, C310.2, C311.2, C312.2, C313.2, C314.2, C315.2, C316.2, C317.2, D303.2 (A), D304.2 (A), Q301.2 (S), R301.2, R306.1, R307.1, R308.1, R309.1, R311.1, U301.6 (PGND), U301.15 (GND/DAP), U302.6 (PDLY), U302.11 (GND), U302.12 (GND), U302.13 (GND), U302.14 (GND), U302.15 (GND), U303.3 (GND), U303.4 (GND), U303.7 (EP), U304.3 (GND), U304.4 (GND), U304.7 (EP), U305.1 (GND), Z301.2 (A); also elsewhere on the board

Notes on the sheet:
Full Bridge Rectifier
PoDL Current Sink
3V3 Main Regulator
3V3 Always on supply
eFuse
R_{PLIM} = 47kΩ ∴ P_{LIM} = 6.82W
UVLO = 9.15V OVP = 34.5V
MODE is auto by default. Setting MODE high means a lower output ripple which may be necessary for the ethernet PHY.
When the device is powered stop requesting power
PR1 > 1V => VOUT = VIN1 PR1 < 1V => VOUT = VIN2
3V3_AON switchover to use most efficient supply.
2A Max
Use high quality, low ESR (<50mΩ) capacitors such as GRM155R61A475ME02
150mA Max
3V3_AON_ST Needs an MCU internal pullup
6.6mA load signals 6.6W requirement to PoDL PSE.
I_{VCC} = 1.2mA
I_{OUT} = V_{IMON} / 5 - 0.001

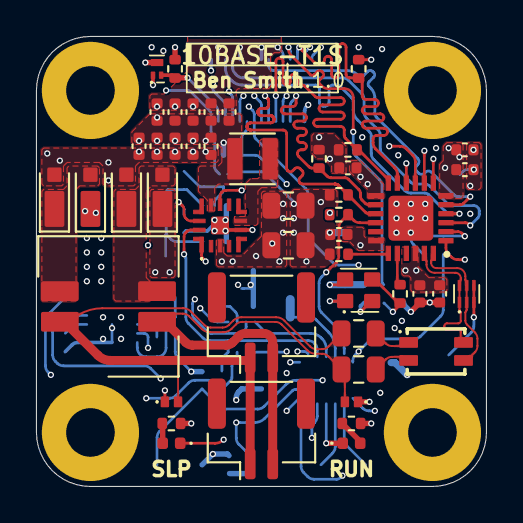
[picture p23: board phy-module-10-base-t1s-v1.kicad_pcb from above]

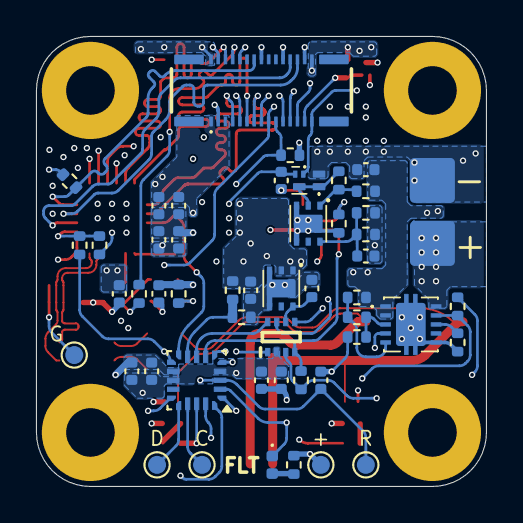
[picture p24: board phy-module-10-base-t1s-v1.kicad_pcb from below]

Board: 6 copper layers, 25.0 x 25.0 mm, 102 parts (50 on the bottom side), 56 nets.
