ben5049/phy-module-hardware/pcbs/test-podl-led/test-podl-led.kicad_pcb

## KiCad design pcbs/test-podl-led/test-podl-led.kicad_pcb (2026-03-18)

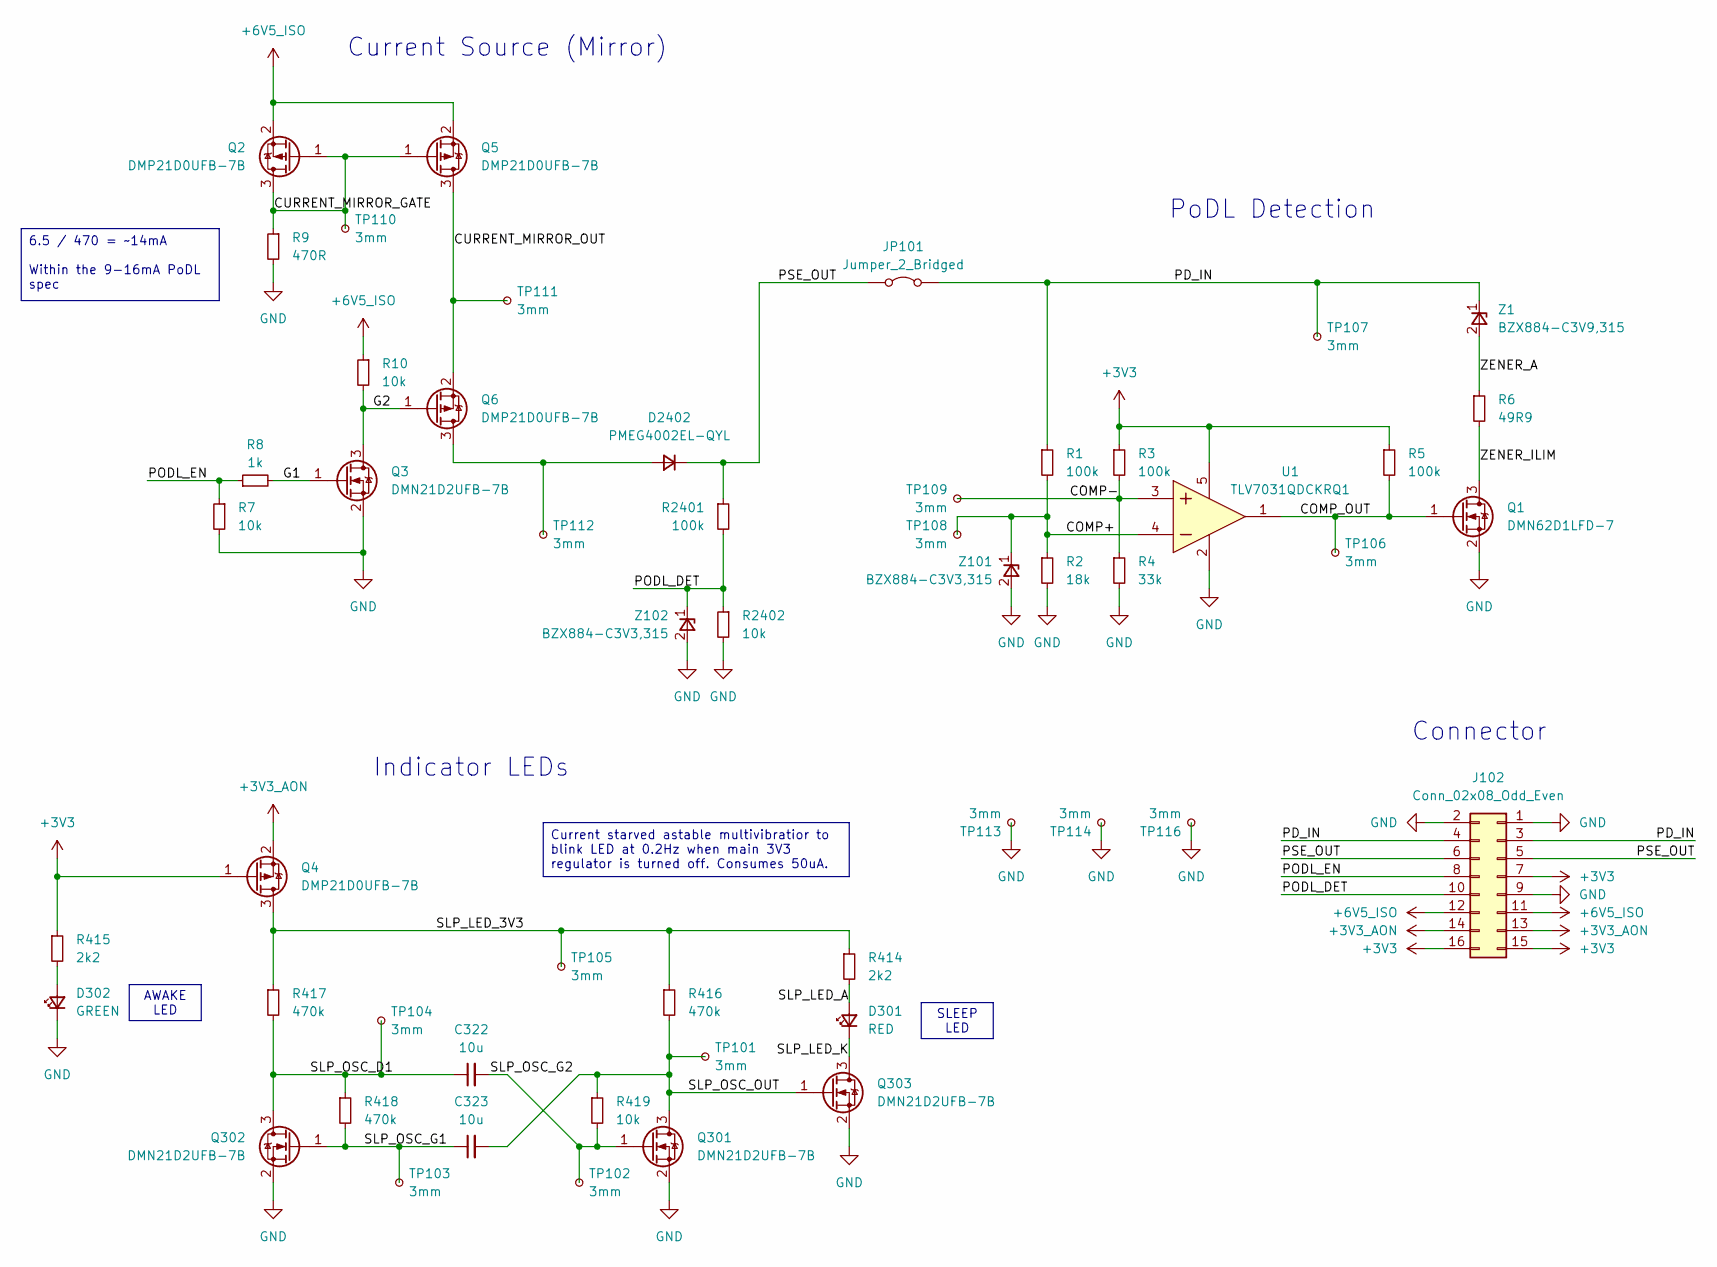
[picture p25: schematic test-podl-led.kicad_sch]

Parts:
C322, C323: 10u; C_0402_1005Metric
D301: RED; LED_0402_1005Metric
D302: GREEN; LED_0402_1005Metric
D2402: PMEG4002EL-QYL
J102: Conn_02x08_Odd_Even; PinHeader_2x08_P2.54mm_Vertical
JP101: Jumper_2_Bridged; PinHeader_1x02_P2.54mm_Vertical
Q1: DMN62D1LFD-7; DMN62D1LFD; Mouser Part Number 621-DMN62D1LFD-7
Q2, Q4, Q5, Q6: DMP21D0UFB-7B; DMP21D0UFB7B; Mouser Part Number 621-DMP21D0UFB-7B
Q3, Q301, Q302, Q303: DMN21D2UFB-7B; DMN21D2UFB7B; Mouser Part Number 621-DMN21D2UFB-7B
R1, R3, R5, R2401: 100k; R_0402_1005Metric
R2: 18k; R_0402_1005Metric
R4: 33k; R_0402_1005Metric
R6: 49R9; R_0402_1005Metric
R7, R10, R419, R2402: 10k; R_0402_1005Metric
R8: 1k; R_0402_1005Metric
R9: 470R; R_0402_1005Metric
R414, R415: 2k2; R_0402_1005Metric
R416, R417, R418: 470k; R_0402_1005Metric
TP101, TP102, TP103, TP104, TP105, TP106, TP107, TP108, TP109, TP110, TP111, TP112, TP113, TP114, TP116: 3mm; TestPoint_Pad_D3.0mm
U1: TLV7031QDCKRQ1; SOT65P210X110-5N; Mouser Part Number 595-TLV7031QDCKRQ1
Z1: BZX884-C3V9,315; BZX884; Mouser Part Number 771-BZX884-C3V9315
Z101, Z102: BZX884-C3V3,315; BZX884; Mouser Part Number 771-BZX884-C3V9315

Connections:
+3V3: J102.7, J102.15, J102.16, Q4.1 (G), R3.1, R5.1, R415.1, U1.5 (VCC)
+3V3_AON: J102.13, J102.14, Q4.2 (S)
+6V5_ISO: J102.11, J102.12, Q2.2 (S), Q5.2 (S), R10.1
/COMP+: R1.2, R2.1, TP108.1, U1.4 (IN-), Z101.1 (K)
/COMP-: R3.2, R4.1, TP109.1, U1.3 (IN+)
/COMP_OUT: Q1.1 (G), R5.2, TP106.1, U1.1 (OUT)
/CURRENT_MIRROR_GATE: Q2.1 (G), Q2.3 (D), Q5.1 (G), R9.1, TP110.1
/CURRENT_MIRROR_OUT: Q5.3 (D), Q6.2 (S), TP111.1
/G1: Q3.1 (G), R8.2
/G2: Q3.3 (D), Q6.1 (G), R10.2
/PD_IN: J102.3, J102.4, JP101.2 (B), R1.1, TP107.1, Z1.1 (K)
/PODL_DET: J102.10, R2401.2, R2402.1, Z102.1 (K)
/PODL_EN: J102.8, R7.1, R8.1
/PSE_OUT: D2402.1 (K), J102.5, J102.6, JP101.1 (A), R2401.1
/SLP_LED_3V3: Q4.3 (D), R414.1, R416.1, R417.1, TP105.1
/SLP_LED_A: D301.2 (A), R414.2
/SLP_LED_K: D301.1 (K), Q303.3 (D)
/SLP_OSC_D1: C322.1, Q302.3 (D), R417.2, R418.1, TP104.1
/SLP_OSC_G1: C323.1, Q302.1 (G), R418.2, TP103.1
/SLP_OSC_G2: C322.2, Q301.1 (G), R419.2, TP102.1
/SLP_OSC_OUT: C323.2, Q301.3 (D), Q303.1 (G), R416.2, R419.1, TP101.1
/ZENER_A: R6.1, Z1.2 (A)
/ZENER_ILIM: Q1.3 (D), Q1.4 (D), R6.2
GND: D302.1 (K), J102.1, J102.2, J102.9, Q1.2 (S), Q3.2 (S), Q301.2 (S), Q302.2 (S), Q303.2 (S), R2.2, R4.2, R7.2, R9.2, R2402.2, TP113.1, TP114.1, TP116.1, U1.2 (VEE), Z101.2 (A), Z102.2 (A)
unnamed: D302.2 (A), R415.2
unnamed: D2402.2 (A), Q6.3 (D), TP112.1

Notes on the sheet:
Connector
PoDL Detection
Indicator LEDs
Current Source (Mirror)
SLEEP LED
6.5 / 470 = ~14mA Within the 9-16mA PoDL spec
Current starved astable multivibratior to blink LED at 0.2Hz when main 3V3 regulator is turned off. Consumes 50uA.
AWAKE LED

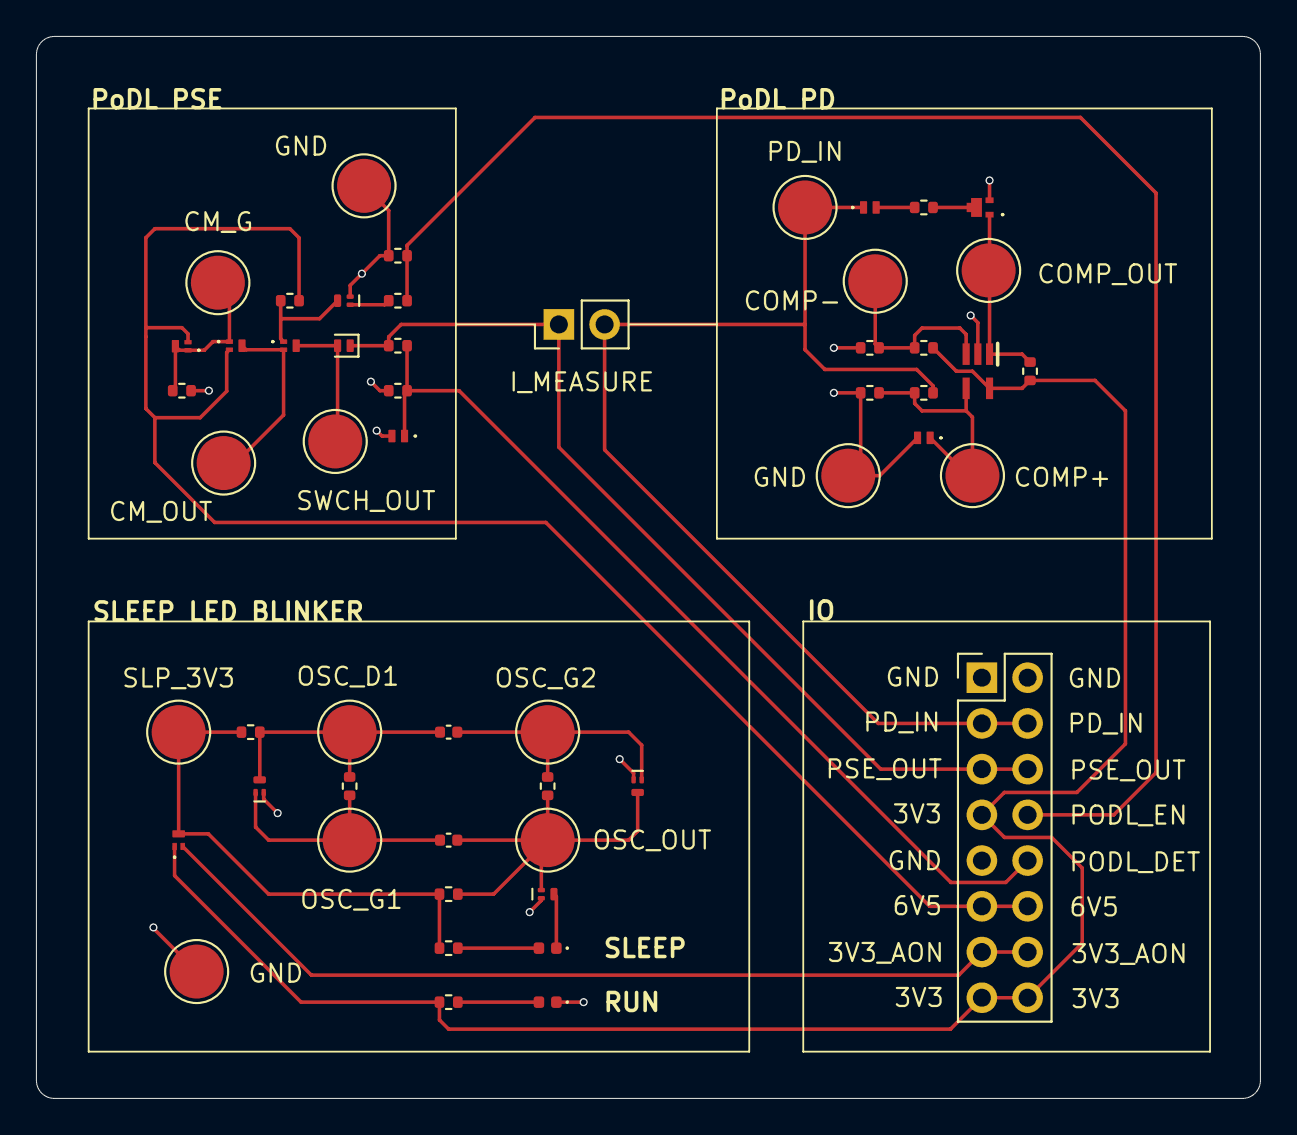
[picture p26: board test-podl-led.kicad_pcb from above]

Board: 2 copper layers, 68.0 x 59.0 mm, 53 parts (0 on the bottom side), 26 nets.
