ben5049/phy-module-hardware/pcbs/phy-module-1000-base-t1-v1/phy-module-1000-base-t1-v1.kicad_pcb

## KiCad design pcbs/phy-module-1000-base-t1-v1/phy-module-1000-base-t1-v1.kicad_pcb (2026-03-18)

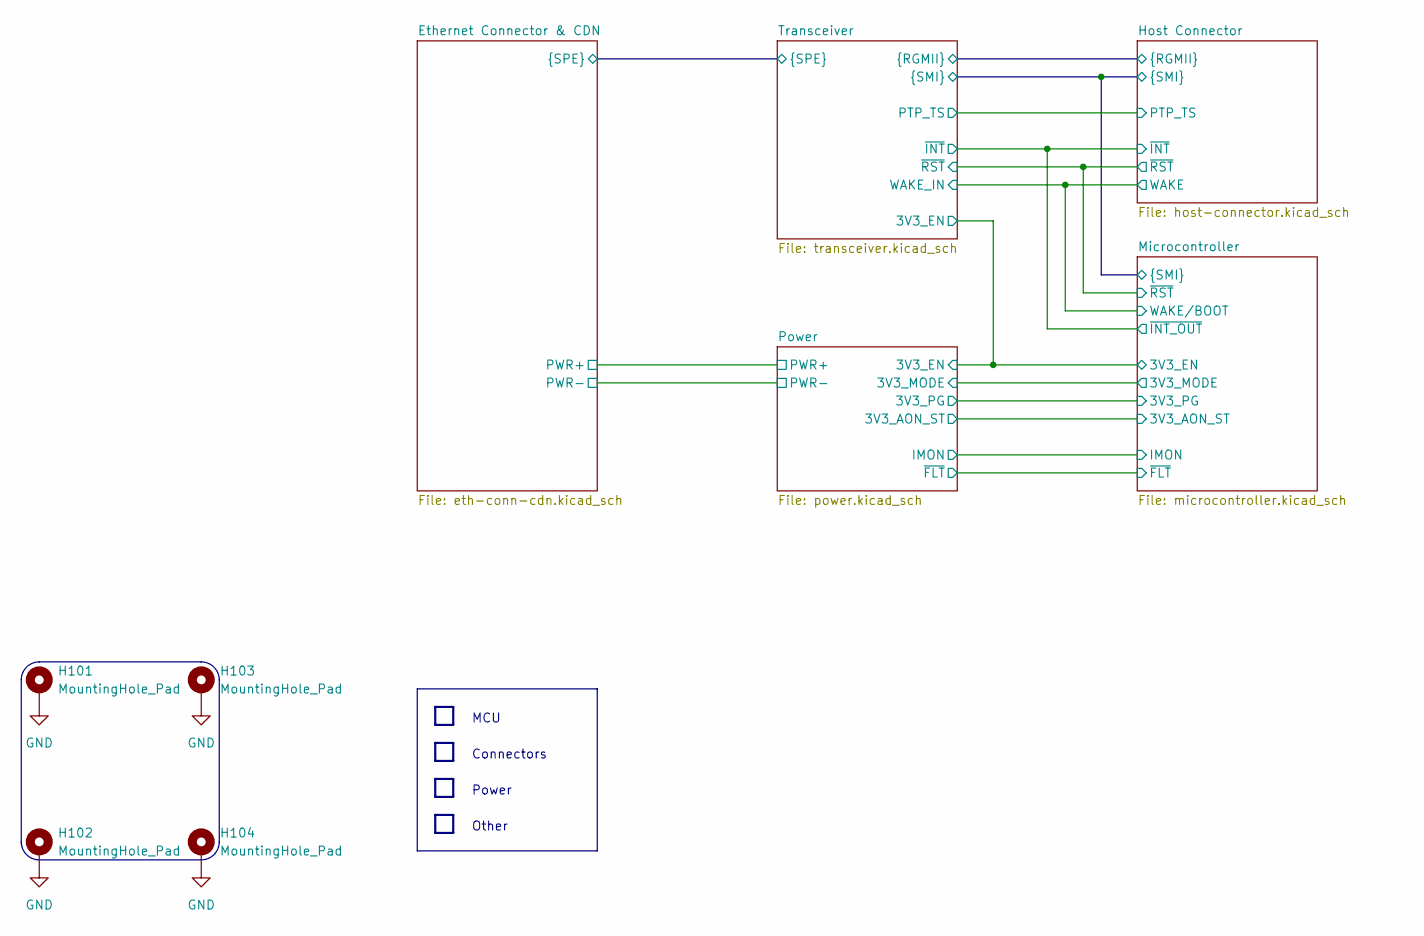
[picture p27: schematic phy-module-1000-base-t1-v1.kicad_sch]

Parts:
H101, H102, H103, H104: MountingHole_Pad; MountingHole_2.7mm_M2.5_Pad

Connections:
GND: H101.1, H102.1, H103.1, H104.1; also elsewhere on the board

Notes on the sheet:
Other
Connectors
MCU
Power

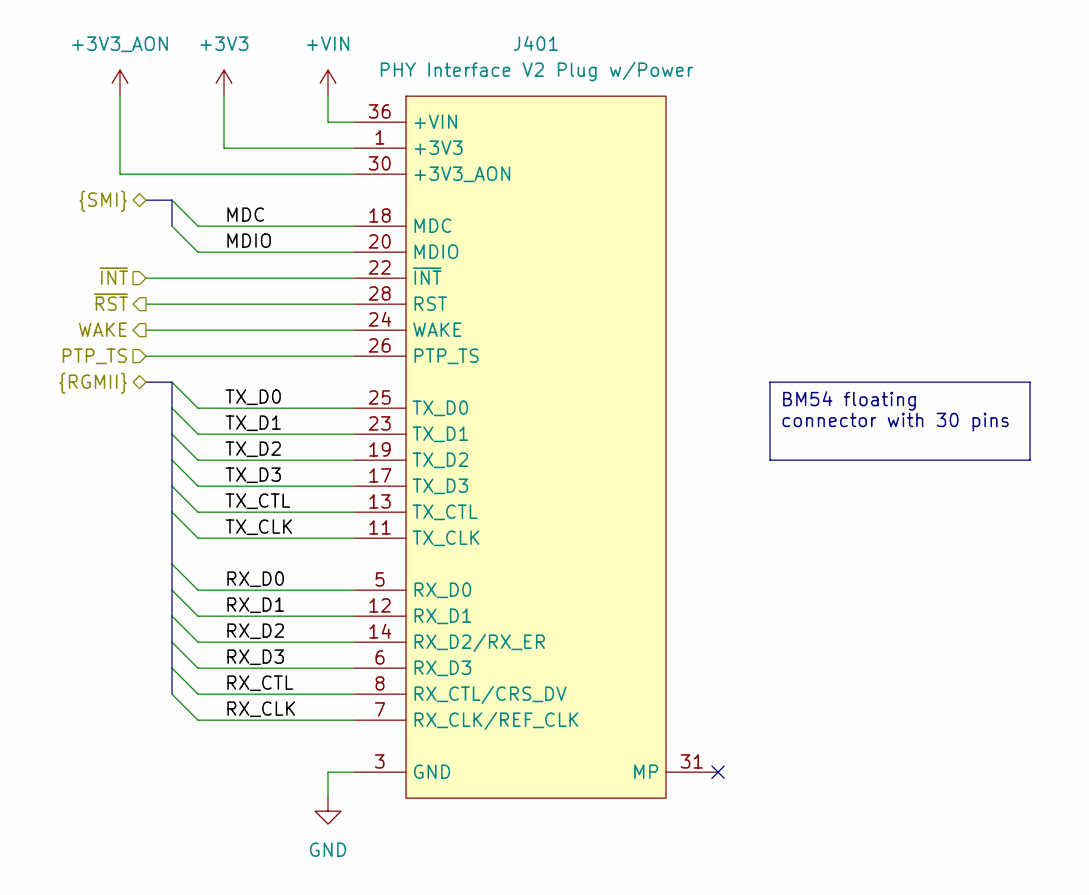
[picture p28: schematic host-connector.kicad_sch]

Parts:
J401: PHY Interface V2 Plug w/Power; BM54F3030DP04V51-PWR

Connections:
+3V3: J401.1 (+3V3), J401.2 (+3V3), J401.29 (+3V3); also elsewhere on the board
+3V3_AON: J401.30 (+3V3_AON); also elsewhere on the board
+VIN: J401.36 (+VIN); also elsewhere on the board
/Host Connector/MDC: J401.18 (MDC); also elsewhere on the board
/Host Connector/MDIO: J401.20 (MDIO); also elsewhere on the board
/Host Connector/PTP_TS: J401.26 (PTP_TS); also elsewhere on the board
/Host Connector/RX_CLK: J401.7 (RX_CLK/REF_CLK); also elsewhere on the board
/Host Connector/RX_CTL: J401.8 (RX_CTL/CRS_DV); also elsewhere on the board
/Host Connector/RX_D0: J401.5 (RX_D0); also elsewhere on the board
/Host Connector/RX_D1: J401.12 (RX_D1); also elsewhere on the board
/Host Connector/RX_D2: J401.14 (RX_D2/RX_ER); also elsewhere on the board
/Host Connector/RX_D3: J401.6 (RX_D3); also elsewhere on the board
/Host Connector/TX_CLK: J401.11 (TX_CLK); also elsewhere on the board
/Host Connector/TX_CTL: J401.13 (TX_CTL); also elsewhere on the board
/Host Connector/TX_D0: J401.25 (TX_D0); also elsewhere on the board
/Host Connector/TX_D1: J401.23 (TX_D1); also elsewhere on the board
/Host Connector/TX_D2: J401.19 (TX_D2); also elsewhere on the board
/Host Connector/TX_D3: J401.17 (TX_D3); also elsewhere on the board
/Host Connector/WAKE: J401.24 (WAKE); also elsewhere on the board
/Host Connector/~INT: J401.22 (~INT); also elsewhere on the board
/Host Connector/~RST: J401.28 (RST); also elsewhere on the board
GND: J401.3 (GND), J401.4 (GND), J401.9 (GND), J401.10 (GND), J401.15 (GND), J401.16 (GND), J401.21 (GND), J401.27 (GND), J401.35 (GND); also elsewhere on the board

Notes on the sheet:
BM54 floating connector with 30 pins

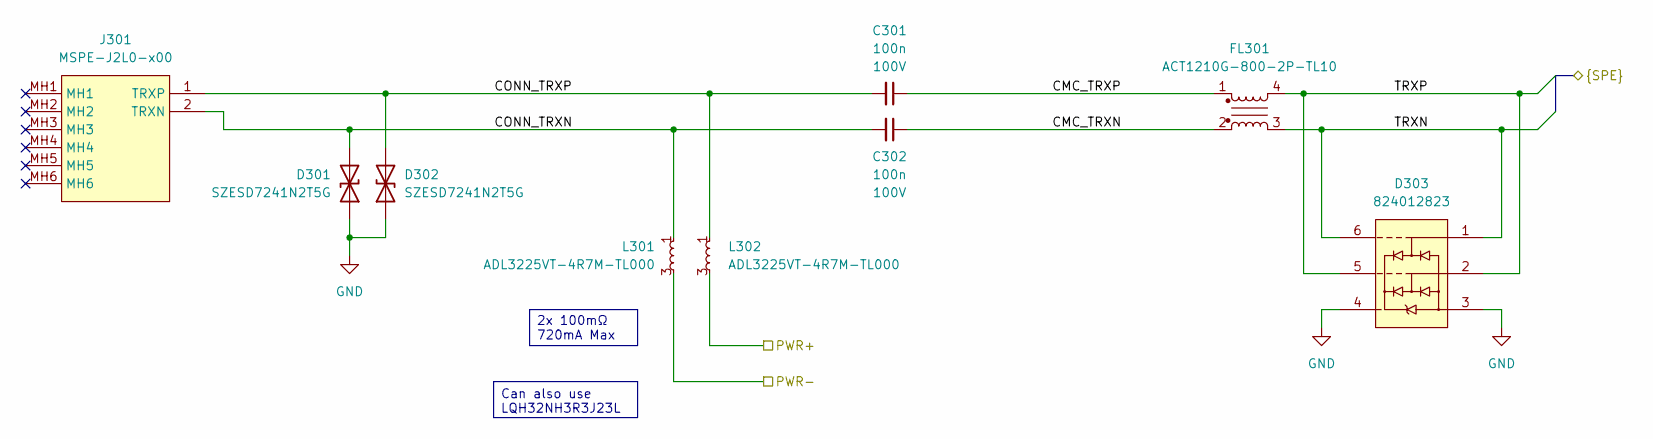
[picture p29: schematic eth-conn-cdn.kicad_sch]

Parts:
C301, C302: 100n; C_0603; Voltage 100V
D301, D302: SZESD7241N2T5G; SZESD7462N2T5G; Mouser Part Number 863-SZESD7241N2T5G
D303: 824012823; Mouser Part Number 710-824012823
FL301: ACT1210G-800-2P-TL10; ACT1210G; Mouser Part Number 810-ACT1210G8002PTL1
J301: MSPE-J2L0-x00; MSPEJ2L0x00; Mouser Part Number 523-MSPE-J2L0-B00
L301, L302: ADL3225VT-4R7M-TL000; ADL3225VT4R7MTL000; Mouser Part Number 810-ADL3225VT4R7MTL0

Connections:
/Ethernet Connector & CDN/CMC_TRXN: C302.1, FL301.2
/Ethernet Connector & CDN/CMC_TRXP: C301.1, FL301.1
/Ethernet Connector & CDN/CONN_TRXN: C302.2, D301.2 (A2), J301.2 (TRXN), L301.1, L301.2
/Ethernet Connector & CDN/CONN_TRXP: C301.2, D302.2 (A2), J301.1 (TRXP), L302.1, L302.2
/Ethernet Connector & CDN/PWR+: L302.3, L302.4; also elsewhere on the board
/Ethernet Connector & CDN/PWR-: L301.3, L301.4; also elsewhere on the board
/Ethernet Connector & CDN/TRXN: D303.1, D303.6, FL301.3; also elsewhere on the board
/Ethernet Connector & CDN/TRXP: D303.2, D303.5, FL301.4; also elsewhere on the board
GND: D301.1 (A1), D302.1 (A1), D303.3, D303.4; also elsewhere on the board

Notes on the sheet:
2x 100mΩ 720mA Max
Can also use LQH32NH3R3J23L

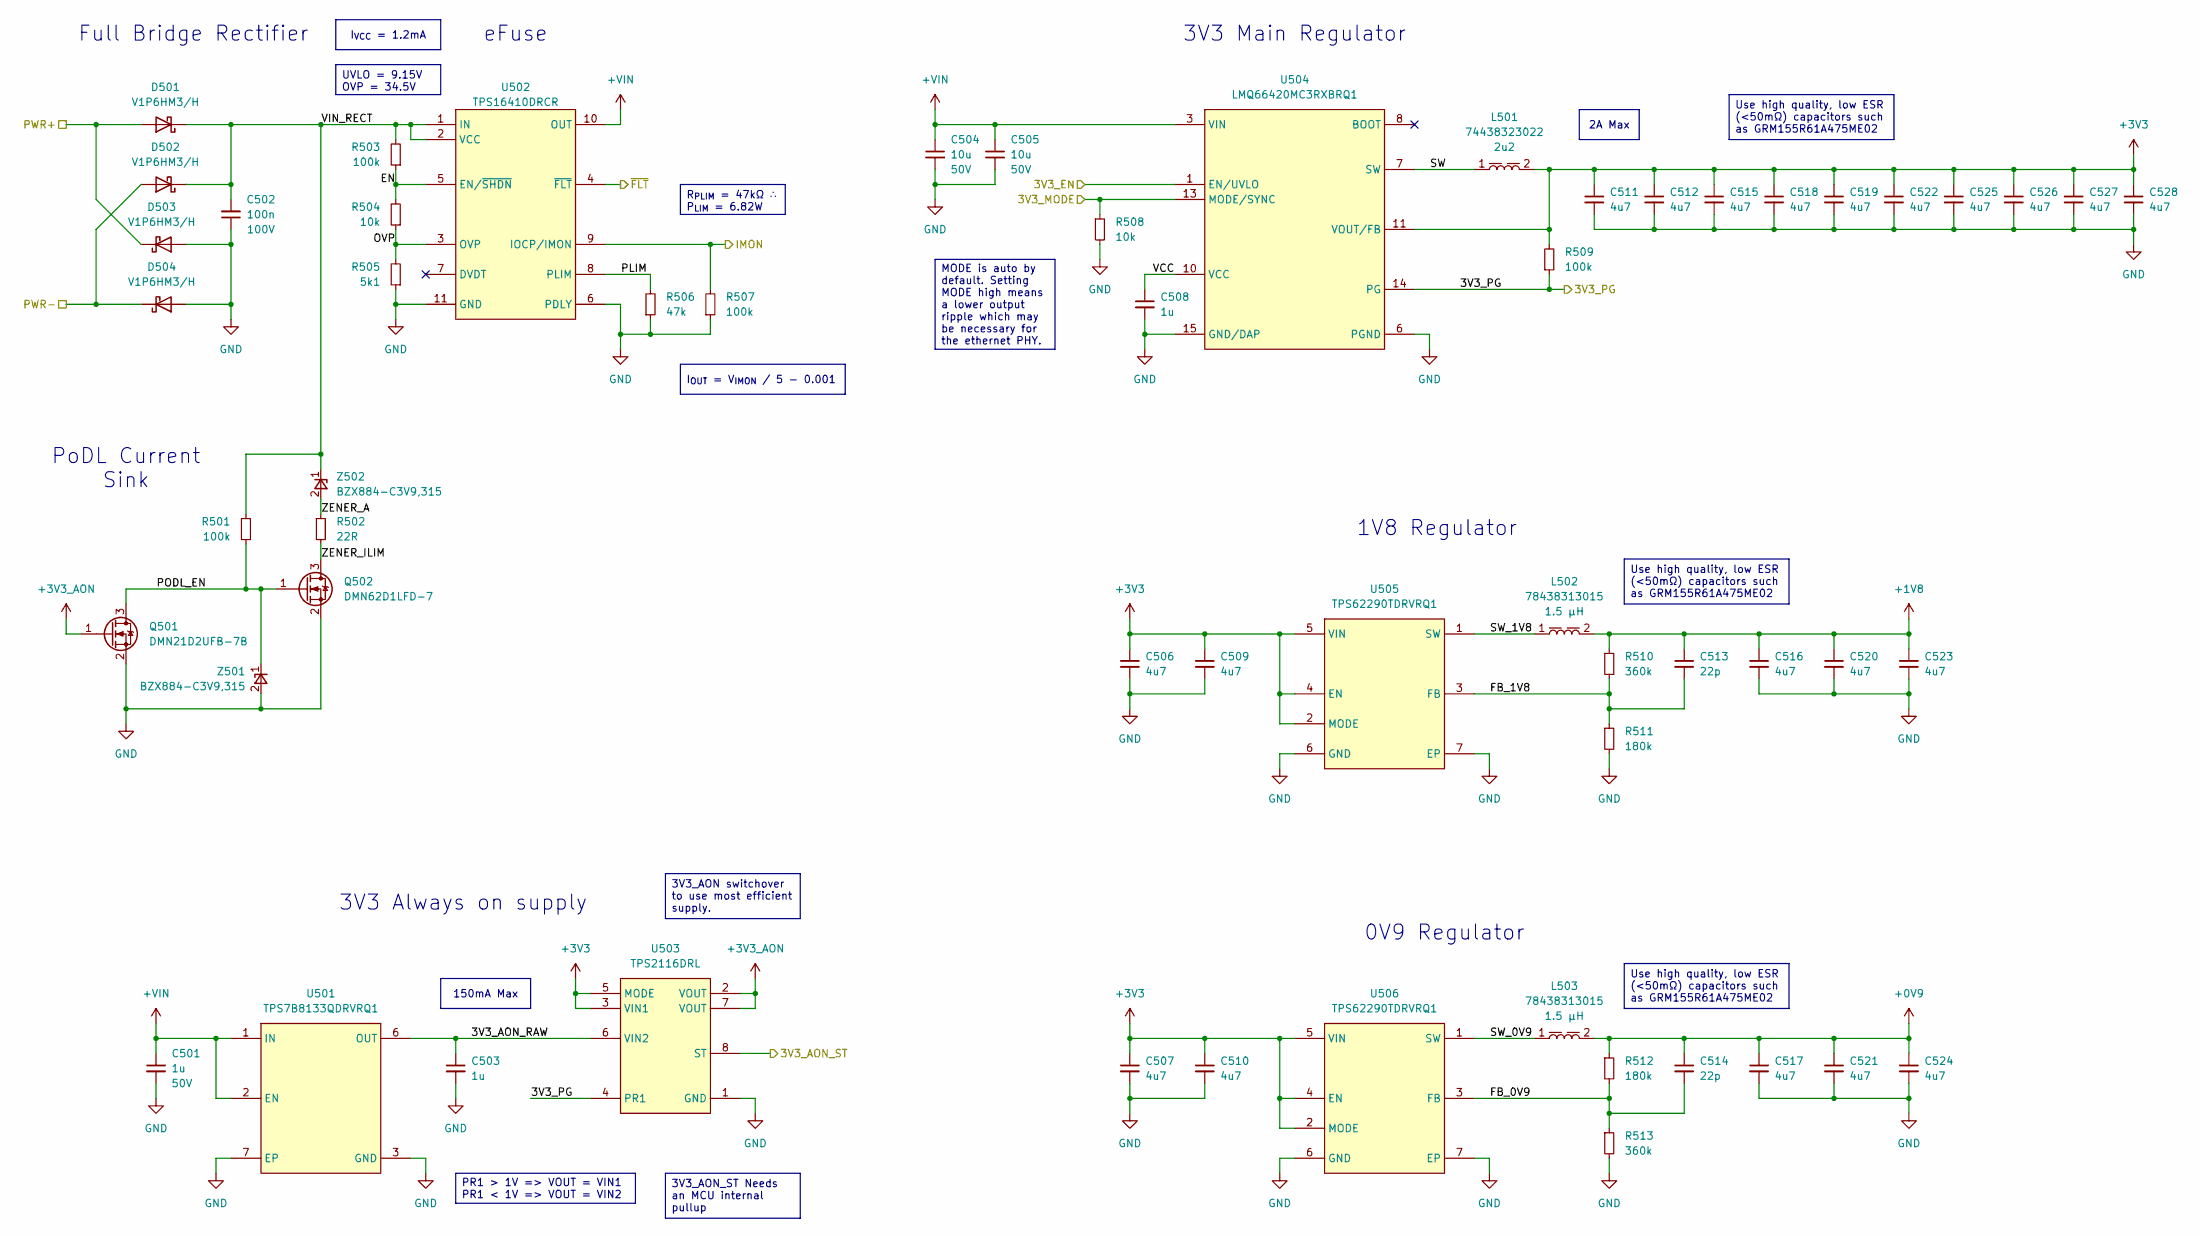
[picture p30: schematic power.kicad_sch]

Parts:
C501: 1u; C_0402; Voltage 50V
C502: 100n; C_0402; Voltage 100V
C503, C508: 1u; C_0402
C504, C505: 10u; C_0805; Voltage 50V
C506, C507, C509, C510, C511, C512, C515, C516, C517, C518, C519, C520, C521, C522, C523, C524, C525, C526, C527, C528: 4u7; C_0402
C513, C514: 22p; C_0402
D501, D502, D503, D504: V1P6HM3/H; V1P6HM3_H
L501: 74438323022; L_Wurth_WE-MAPI-2510; Part Number 74438323022
L502, L503: 78438313015; L_Wurth_WE-MAIA-1610; Part Number 78438313015
Q501: DMN21D2UFB-7B; DMN21D2UFB7B; Mouser Part Number 621-DMN21D2UFB-7B
Q502: DMN62D1LFD-7; DMN62D1LFD; Mouser Part Number 621-DMN62D1LFD-7
R501, R503, R507, R509: 100k; R_0402
R502: 22R; R_0402
R504, R508: 10k; R_0402
R505: 5k1; R_0402
R506: 47k; R_0402
R510, R513: 360k; R_0402
R511, R512: 180k; R_0402
U501: TPS7B8133QDRVRQ1; SON65P200X200X80-7N; Mouser Part Number 595-TPS7B8133QDRVRQ1
U502: TPS16410DRCR; Mouser Part Number 595-TPS16410DRCR
U503: TPS2116DRL; SOTFL50P160X60-8N
U504: LMQ66420MC3RXBRQ1; LMQ664x0
U505, U506: TPS62290TDRVRQ1; SON65P200X200X80-7N; Mouser Part Number 595-TPS62290TDRVRQ1
Z501, Z502: BZX884-C3V9,315; BZX884; Mouser Part Number 771-BZX884-C3V9315

Connections:
+0V9: C514.1, C517.1, C521.1, C524.1, L503.2, R512.1; also elsewhere on the board
+1V8: C513.1, C516.1, C520.1, C523.1, L502.2, R510.1; also elsewhere on the board
+3V3: C506.1, C507.1, C509.1, C510.1, C511.1, C512.1, C515.1, C518.1, C519.1, C522.1, C525.1, C526.1, C527.1, C528.1, L501.2, R509.2, U503.3 (VIN1), U503.5 (MODE), U504.11 (VOUT/FB), U505.2 (MODE), U505.4 (EN), U505.5 (VIN), U506.2 (MODE), U506.4 (EN), U506.5 (VIN); also elsewhere on the board
+3V3_AON: Q501.1 (G), U503.2 (VOUT), U503.7 (VOUT); also elsewhere on the board
+VIN: C501.1, C504.1, C505.1, U501.1 (IN), U501.2 (EN), U502.10 (OUT), U504.3 (VIN); also elsewhere on the board
/Ethernet Connector & CDN/PWR+: D501.2 (A), D503.1 (K); also elsewhere on the board
/Ethernet Connector & CDN/PWR-: D502.2 (A), D504.1 (K); also elsewhere on the board
/Microcontroller/3V3_AON_ST: U503.8 (ST); also elsewhere on the board
/Microcontroller/3V3_EN: U504.1 (EN/UVLO); also elsewhere on the board
/Microcontroller/3V3_MODE: R508.1, U504.13 (MODE/SYNC); also elsewhere on the board
/Microcontroller/IMON: R507.2, U502.9 (IOCP/IMON); also elsewhere on the board
/Microcontroller/~FLT: U502.4 (~FLT); also elsewhere on the board
/Power/3V3_AON_RAW: C503.1, U501.6 (OUT), U503.6 (VIN2)
/Power/3V3_PG: R509.1, U503.4 (PR1), U504.14 (PG); also elsewhere on the board
/Power/EN: R503.1, R504.2, U502.5 (EN/~SHDN)
/Power/FB_0V9: C514.2, R512.2, R513.1, U506.3 (FB)
/Power/FB_1V8: C513.2, R510.2, R511.1, U505.3 (FB)
/Power/OVP: R504.1, R505.2, U502.3 (OVP)
/Power/PLIM: R506.2, U502.8 (PLIM)
/Power/PODL_EN: Q501.3 (D), Q502.1 (G), R501.1, Z501.1 (K)
/Power/SW: L501.1, U504.7 (SW)
/Power/SW_0V9: L503.1, U506.1 (SW)
/Power/SW_1V8: L502.1, U505.1 (SW)
/Power/VCC: C508.1, U504.10 (VCC)
/Power/VIN_RECT: C502.2, D501.1 (K), D502.1 (K), R501.2, R503.2, U502.1 (IN), U502.2 (VCC), Z502.1 (K)
/Power/ZENER_A: R502.1, Z502.2 (A)
/Power/ZENER_ILIM: Q502.3 (D), Q502.4 (D), R502.2
GND: C501.2, C502.1, C503.2, C504.2, C505.2, C506.2, C507.2, C508.2, C509.2, C510.2, C511.2, C512.2, C515.2, C516.2, C517.2, C518.2, C519.2, C520.2, C521.2, C522.2, C523.2, C524.2, C525.2, C526.2, C527.2, C528.2, D503.2 (A), D504.2 (A), Q501.2 (S), Q502.2 (S), R505.1, R506.1, R507.1, R508.2, R511.2, R513.2, U501.3 (GND), U501.4 (GND), U501.7 (EP), U502.6 (PDLY), U502.11 (GND), U502.12 (GND), U502.13 (GND), U502.14 (GND), U502.15 (GND), U503.1 (GND), U504.6 (PGND), U504.15 (GND/DAP), U505.6 (GND), U505.7 (EP), U506.6 (GND), U506.7 (EP), Z501.2 (A); also elsewhere on the board

Notes on the sheet:
1V8 Regulator
Full Bridge Rectifier
3V3 Main Regulator
PoDL Current Sink
0V9 Regulator
3V3 Always on supply
eFuse
R_{PLIM} = 47kΩ ∴ P_{LIM} = 6.82W
UVLO = 9.15V OVP = 34.5V
MODE is auto by default. Setting MODE high means a lower output ripple which may be necessary for the ethernet PHY.
PR1 > 1V => VOUT = VIN1 PR1 < 1V => VOUT = VIN2
3V3_AON switchover to use most efficient supply.
2A Max
Use high quality, low ESR (<50mΩ) capacitors such as GRM155R61A475ME02
150mA Max
3V3_AON_ST Needs an MCU internal pullup
I_{VCC} = 1.2mA
I_{OUT} = V_{IMON} / 5 - 0.001

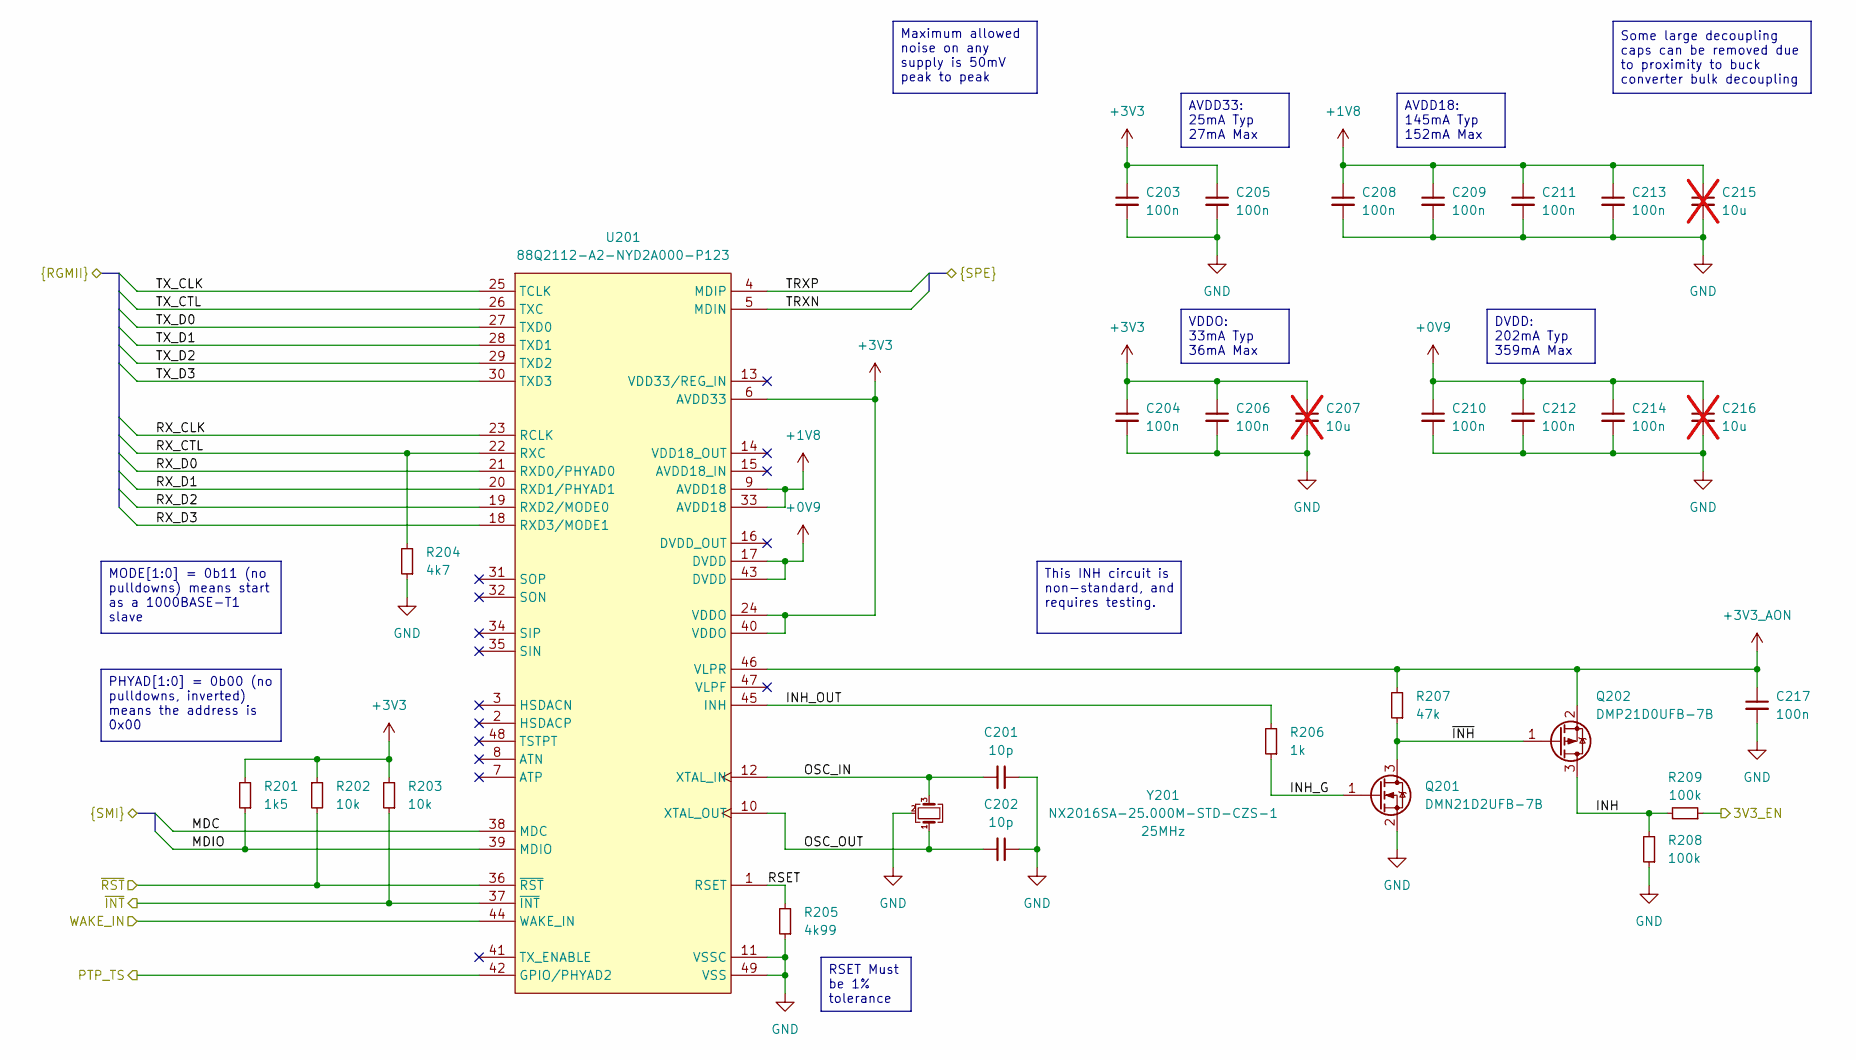
[picture p31: schematic transceiver.kicad_sch]

Parts:
C201, C202: 10p; C_0402
C203, C204, C205, C206, C208, C209, C210, C211, C212, C213, C214, C217: 100n; C_0402
C207, C215, C216: 10u; C_0402; not fitted
Q201: DMN21D2UFB-7B; DMN21D2UFB7B; Mouser Part Number 621-DMN21D2UFB-7B
Q202: DMP21D0UFB-7B; DMP21D0UFB7B; Mouser Part Number 621-DMP21D0UFB-7B
R201: 1k5; R_0402
R202, R203: 10k; R_0402
R204: 4k7; R_0402
R205: 4k99; R_0402
R206: 1k; R_0402
R207: 47k; R_0402
R208, R209: 100k; R_0402
U201: 88Q2112-A2-NYD2A000-P123; 88Q2112
Y201: NX2016SA-25.000M-STD-CZS-1; NX2016SA-40M-STD-CZS-3

Connections:
+0V9: C210.1, C212.1, C214.1, C216.1, U201.17 (DVDD), U201.43 (DVDD); also elsewhere on the board
+1V8: C208.1, C209.1, C211.1, C213.1, C215.1, U201.9 (AVDD18), U201.33 (AVDD18); also elsewhere on the board
+3V3: C203.1, C204.1, C205.1, C206.1, C207.1, R201.2, R202.1, R203.2, U201.6 (AVDD33), U201.24 (VDDO), U201.40 (VDDO); also elsewhere on the board
+3V3_AON: C217.1, Q202.2 (S), R207.2, U201.46 (VLPR); also elsewhere on the board
/Ethernet Connector & CDN/TRXN: U201.5 (MDIN); also elsewhere on the board
/Ethernet Connector & CDN/TRXP: U201.4 (MDIP); also elsewhere on the board
/Host Connector/MDC: U201.38 (MDC); also elsewhere on the board
/Host Connector/MDIO: R201.1, U201.39 (MDIO); also elsewhere on the board
/Host Connector/PTP_TS: U201.42 (GPIO/PHYAD2); also elsewhere on the board
/Host Connector/RX_CLK: U201.23 (RCLK); also elsewhere on the board
/Host Connector/RX_CTL: R204.2, U201.22 (RXC); also elsewhere on the board
/Host Connector/RX_D0: U201.21 (RXD0/PHYAD0); also elsewhere on the board
/Host Connector/RX_D1: U201.20 (RXD1/PHYAD1); also elsewhere on the board
/Host Connector/RX_D2: U201.19 (RXD2/MODE0); also elsewhere on the board
/Host Connector/RX_D3: U201.18 (RXD3/MODE1); also elsewhere on the board
/Host Connector/TX_CLK: U201.25 (TCLK); also elsewhere on the board
/Host Connector/TX_CTL: U201.26 (TXC); also elsewhere on the board
/Host Connector/TX_D0: U201.27 (TXD0); also elsewhere on the board
/Host Connector/TX_D1: U201.28 (TXD1); also elsewhere on the board
/Host Connector/TX_D2: U201.29 (TXD2); also elsewhere on the board
/Host Connector/TX_D3: U201.30 (TXD3); also elsewhere on the board
/Host Connector/WAKE: U201.44 (WAKE_IN); also elsewhere on the board
/Host Connector/~INT: R203.1, U201.37 (~INT); also elsewhere on the board
/Host Connector/~RST: R202.2, U201.36 (~RST); also elsewhere on the board
/Microcontroller/3V3_EN: R209.1; also elsewhere on the board
/Transceiver/INH: Q202.3 (D), R208.2, R209.2
/Transceiver/INH_G: Q201.1 (G), R206.1
/Transceiver/INH_OUT: R206.2, U201.45 (INH)
/Transceiver/OSC_IN: C201.2, U201.12 (XTAL_IN), Y201.3
/Transceiver/OSC_OUT: C202.2, U201.10 (XTAL_OUT), Y201.1
/Transceiver/RSET: R205.2, U201.1 (RSET)
/Transceiver/~INH: Q201.3 (D), Q202.1 (G), R207.1
GND: C201.1, C202.1, C203.2, C204.2, C205.2, C206.2, C207.2, C208.2, C209.2, C210.2, C211.2, C212.2, C213.2, C214.2, C215.2, C216.2, C217.2, Q201.2 (S), R204.1, R205.1, R208.1, U201.11 (VSSC), U201.49 (VSS), Y201.2 (G), Y201.4 (G); also elsewhere on the board

Notes on the sheet:
Maximum allowed noise on any supply is 50mV peak to peak
RSET Must be 1% tolerance
This INH circuit is non-standard, and requires testing.
Some large decoupling caps can be removed due to proximity to buck converter bulk decoupling
PHYAD[1:0] = 0b00 (no pulldowns, inverted) means the address is 0x00
DVDD: 202mA Typ 359mA Max
MODE[1:0] = 0b11 (no pulldowns) means start as a 1000BASE-T1 slave
VDDO: 33mA Typ 36mA Max
AVDD33: 25mA Typ 27mA Max
AVDD18: 145mA Typ 152mA Max

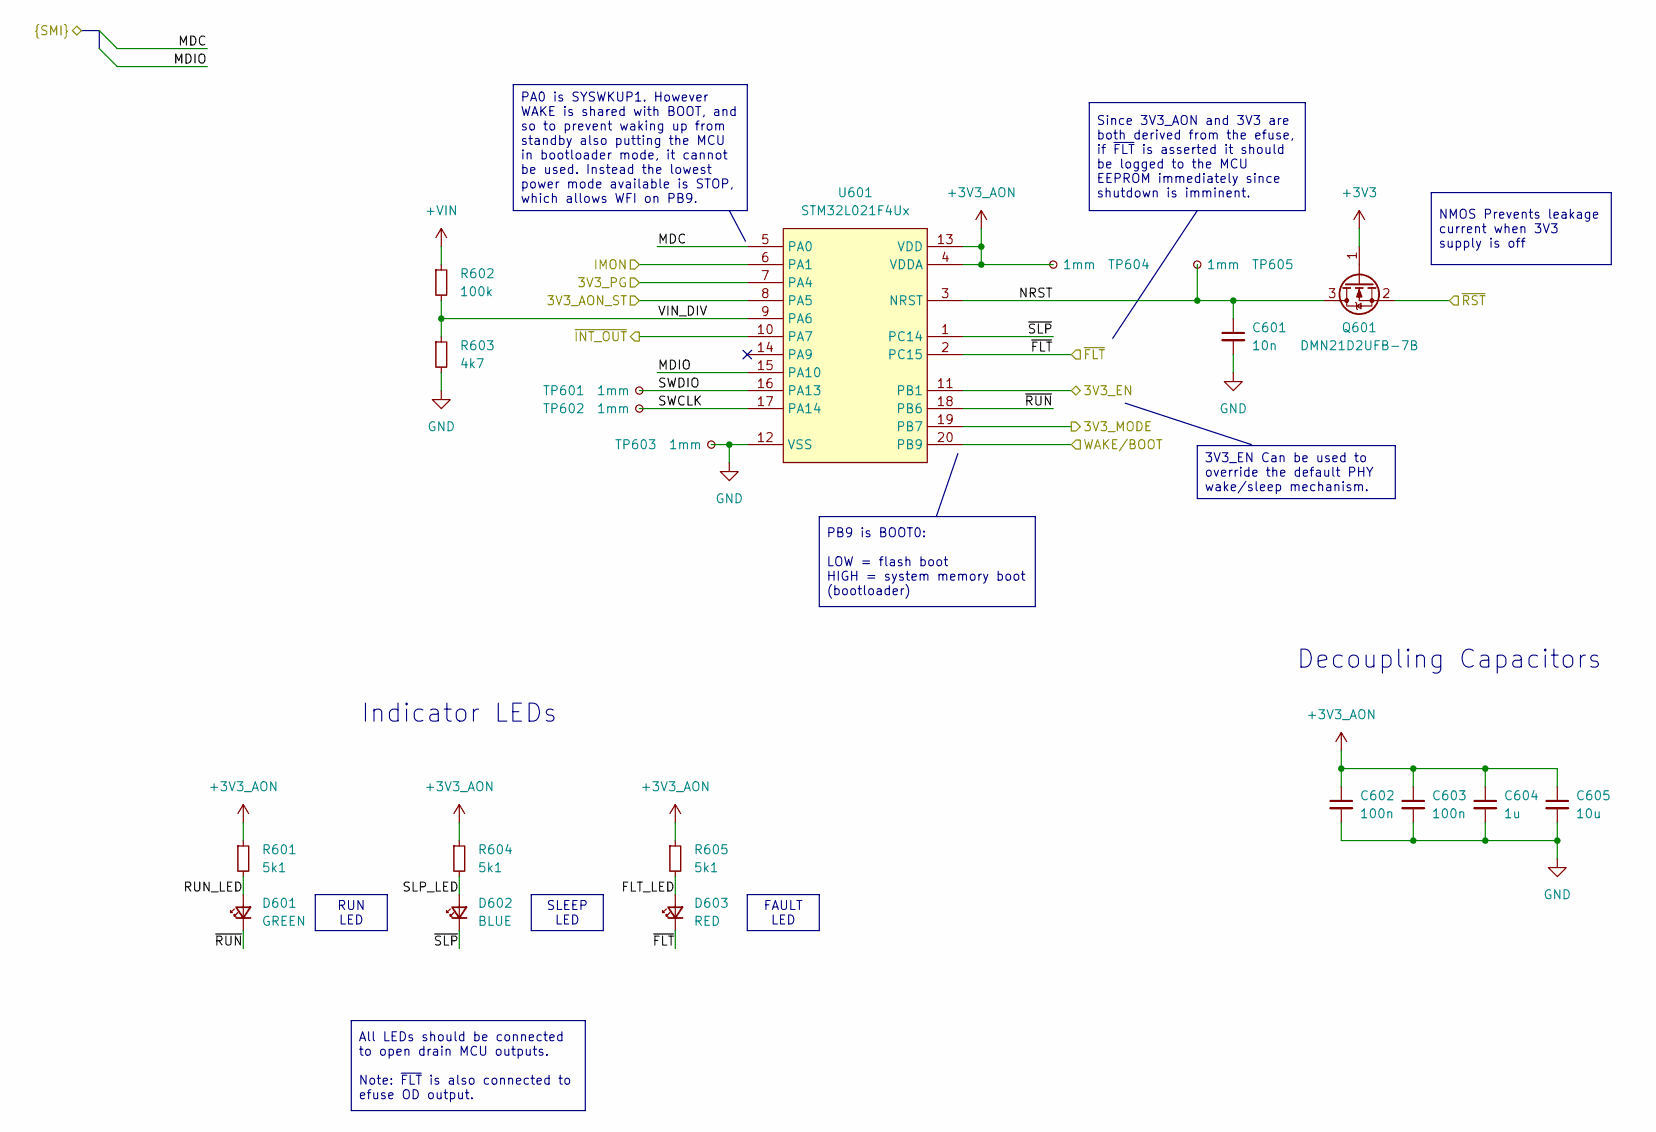
[picture p32: schematic microcontroller.kicad_sch]

Parts:
C601: 10n; C_0402
C602, C603: 100n; C_0402
C604: 1u; C_0402
C605: 10u; C_0402
D601: GREEN; LED_0402
D602: BLUE; LED_0402
D603: RED; LED_0402
Q601: DMN21D2UFB-7B; DMN21D2UFB7B; Mouser Part Number 621-DMN21D2UFB-7B
R601, R604, R605: 5k1; R_0402
R602: 100k; R_0402
R603: 4k7; R_0402
TP601, TP602, TP603, TP604, TP605: 1mm; TestPoint_Pad_D1.0mm
U601: STM32L021F4Ux; ST_UFQFPN-20_3x3mm_P0.5mm

Connections:
+3V3: Q601.1 (G); also elsewhere on the board
+3V3_AON: C602.1, C603.1, C604.1, C605.1, R601.1, R604.1, R605.1, TP604.1, U601.4 (VDDA), U601.13 (VDD); also elsewhere on the board
+VIN: R602.1; also elsewhere on the board
/Host Connector/MDC: U601.5 (PA0); also elsewhere on the board
/Host Connector/MDIO: U601.15 (PA10); also elsewhere on the board
/Host Connector/WAKE: U601.20 (PB9); also elsewhere on the board
/Host Connector/~INT: U601.10 (PA7); also elsewhere on the board
/Host Connector/~RST: Q601.2 (S); also elsewhere on the board
/Microcontroller/3V3_AON_ST: U601.8 (PA5); also elsewhere on the board
/Microcontroller/3V3_EN: U601.11 (PB1); also elsewhere on the board
/Microcontroller/3V3_MODE: U601.19 (PB7); also elsewhere on the board
/Microcontroller/FLT_LED: D603.2 (A), R605.2
/Microcontroller/IMON: U601.6 (PA1); also elsewhere on the board
/Microcontroller/NRST: C601.1, Q601.3 (D), TP605.1, U601.3 (NRST)
/Microcontroller/RUN_LED: D601.2 (A), R601.2
/Microcontroller/SLP_LED: D602.2 (A), R604.2
/Microcontroller/SWCLK: TP602.1, U601.17 (PA14)
/Microcontroller/SWDIO: TP601.1, U601.16 (PA13)
/Microcontroller/VIN_DIV: R602.2, R603.1, U601.9 (PA6)
/Microcontroller/~FLT: D603.1 (K), U601.2 (PC15); also elsewhere on the board
/Microcontroller/~RUN: D601.1 (K), U601.18 (PB6)
/Microcontroller/~SLP: D602.1 (K), U601.1 (PC14)
/Power/3V3_PG: U601.7 (PA4); also elsewhere on the board
GND: C601.2, C602.2, C603.2, C604.2, C605.2, R603.2, TP603.1, U601.12 (VSS); also elsewhere on the board

Notes on the sheet:
Decoupling Capacitors
Indicator LEDs
RUN LED
PA0 is SYSWKUP1. However WAKE is shared with BOOT, and so to prevent waking up from standby also putting the MCU in bootloader mode, it cannot be used. Instead the lowest power mode available is STOP, which allows WFI on PB9.
PB9 is BOOT0: LOW = flash boot HIGH = system memory boot (bootloader)
Since 3V3_AON and 3V3 are both derived from the efuse, if ~{FLT} is asserted it should be logged to the MCU EEPROM immediately since shutdown is imminent.
FAULT LED
SLEEP LED
All LEDs should be connected to open drain MCU outputs. Note: ~{FLT} is also connected to efuse OD output.
3V3_EN Can be used to override the default PHY wake/sleep mechanism.
NMOS Prevents leakage current when 3V3 supply is off

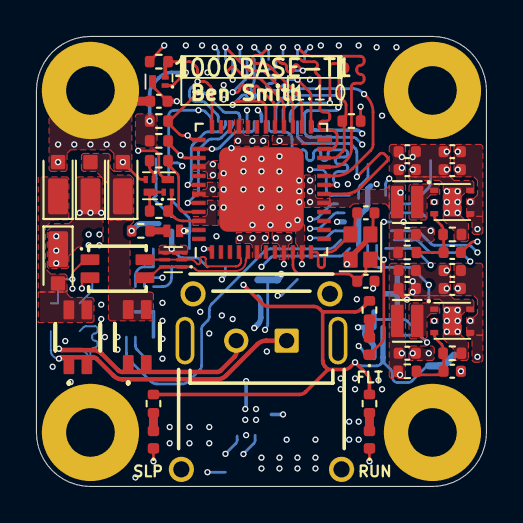
[picture p33: board phy-module-1000-base-t1-v1.kicad_pcb from above]

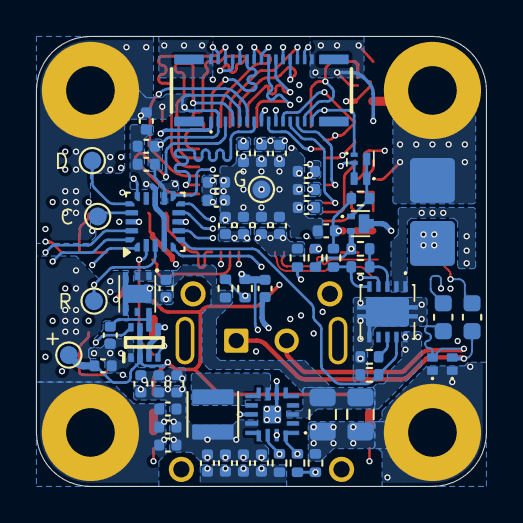
[picture p34: board phy-module-1000-base-t1-v1.kicad_pcb from below]

Board: 6 copper layers, 25.0 x 25.0 mm, 119 parts (64 on the bottom side), 68 nets.
