ben5049/phy-module-hardware/(commit log)

2026-03-18 [common] Added 10BASE-T1S & and 1000BASE-T1 PHY Modules
    [eth-conn-cdn.kicad_sch, host-connector.kicad_sch, microcontroller.kicad_sch, phy-module-10-base-t1s-v1.kicad_pcb, phy-module-10-base-t1s-v1.kicad_sch, phy-module-1000-base-t1-v1.kicad_pcb, phy-module-1000-base-t1-v1.kicad_sch, power.kicad_sch]
2026-03-19 [10base-t1s] Updated schematic symbols
    [eth-conn-cdn.kicad_sch, host-connector.kicad_sch, microcontroller.kicad_sch, phy-module-10-base-t1s-v1.kicad_pcb]
2026-03-31 [term-10base-t1s] Added files
    [term-10base-t1s-v1.kicad_pcb, term-10base-t1s-v1.kicad_sch]
2026-05-04 [10base-t1s-v1] Added config without PoDL
    [eth-conn-cdn.kicad_sch, host-connector.kicad_sch, microcontroller.kicad_sch, phy-module-10-base-t1s-v1.kicad_pcb, phy-module-10-base-t1s-v1.kicad_sch, power.kicad_sch, tranceiver.kicad_sch]
2026-05-05 [10base-t1s-v1] Updated LED footprints
    [microcontroller.kicad_sch, phy-module-10-base-t1s-v1.kicad_pcb]
2026-05-05 [term-10base-t1s] Shrunk to 8mm * 6mm
    [term-10base-t1s-v1.kicad_pcb]
